wittend/PSWS-FX3-HF103/README.md

# PSWS-FX3-HF103
An SDR radio design  based on Oskar Stella's HF103
