wittend/PSWS-FX3-HF103/Local Resources/LTC2208/LTC2208 Demobpard.png

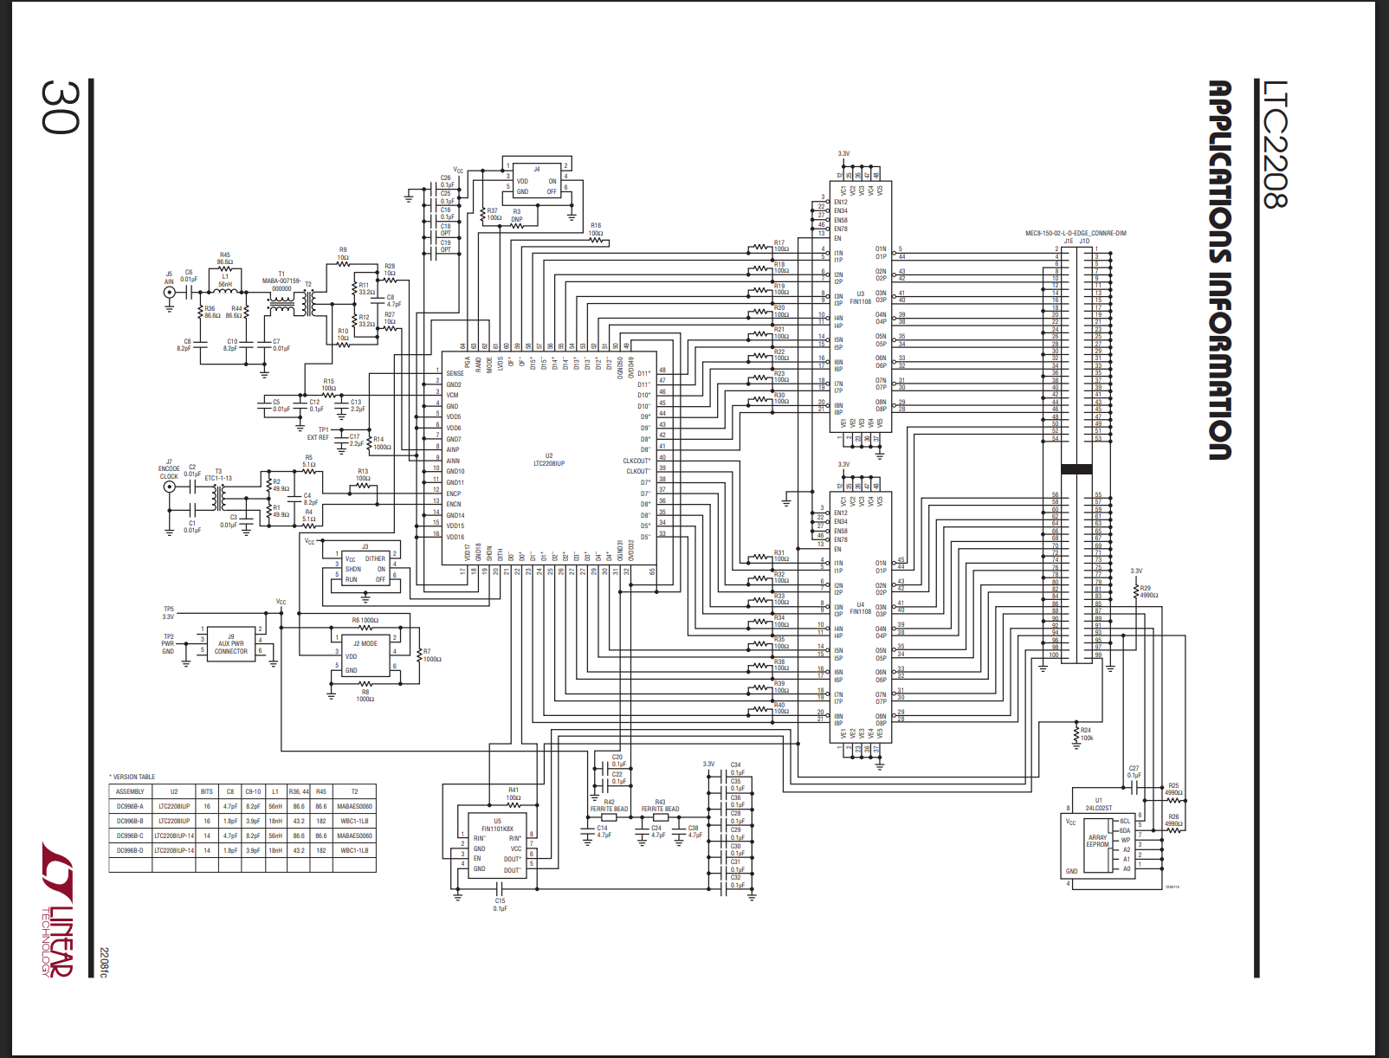
Local Resources/LTC2208/LTC2208 Demobpard.png
