wittend/PSWS-FX3-HF103/Local Resources/CYUSB3014-BZXCT/CYUSB3014-BZXCT.step

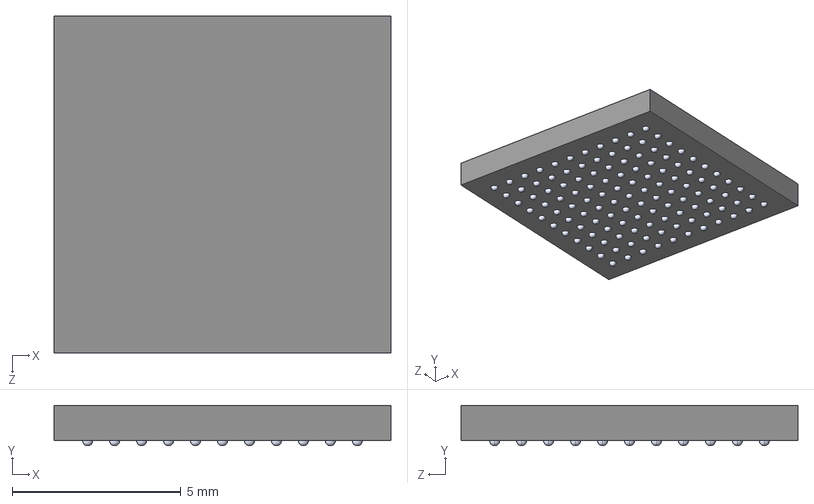
[picture p2: CAD file, 2025-09-26]
Local Resources/CYUSB3014-BZXCT/CYUSB3014-BZXCT.step
10.0 x 1.20 x 10.0 mm
