wittend/PSWS-FX3-HF103/Local Resources/ETC1-1T-2TR/3D/ETC1-1T-2TR.stp

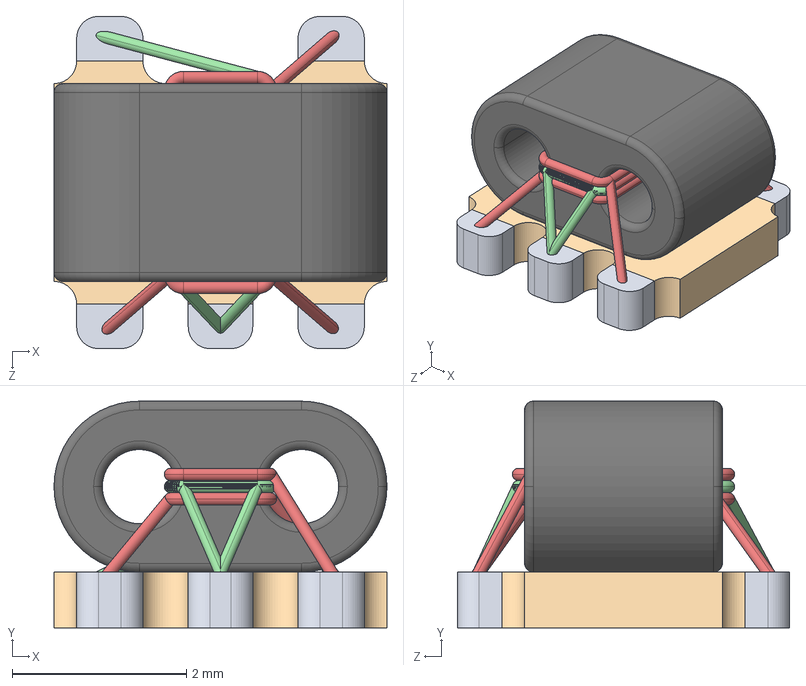
[picture p3: CAD file, 2025-09-26]
Local Resources/ETC1-1T-2TR/3D/ETC1-1T-2TR.stp
3.82 x 2.60 x 3.81 mm
