wittend/PSWS-FX3-HF103/Local Resources/LTC2208/LTC2208CUP_PBF.step

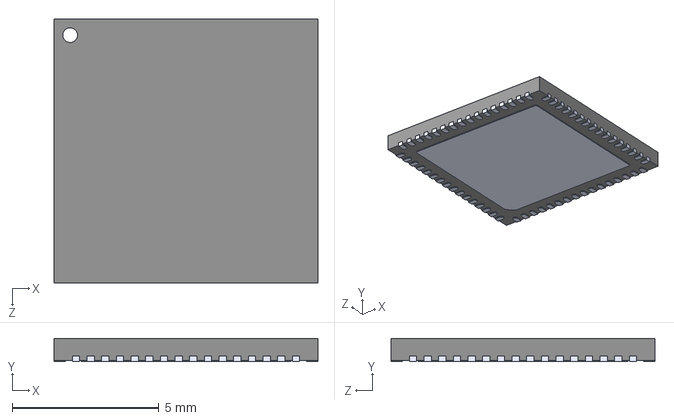
[picture p4: CAD file, 2025-09-26]
Local Resources/LTC2208/LTC2208CUP_PBF.step
9.00 x 0.8 x 9.00 mm
