wittend/PSWS-FX3-HF103/Local Resources/Si5351/SI5351A-B-GT.step

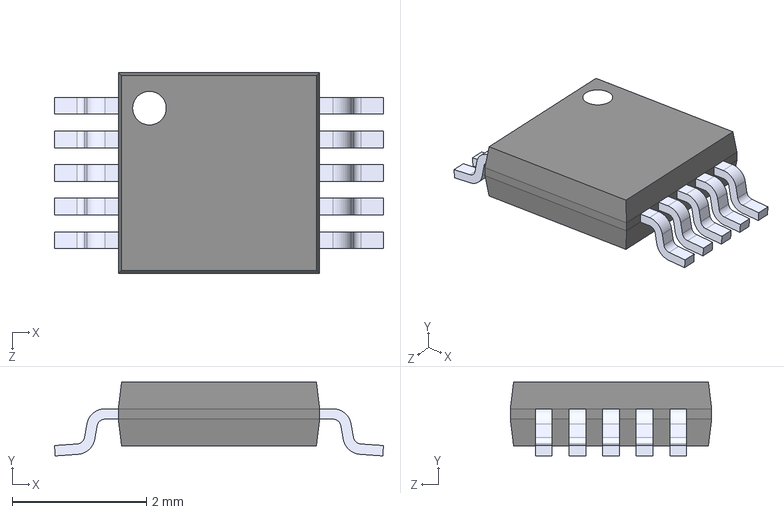
[picture p5: CAD file, 2025-09-26]
Local Resources/Si5351/SI5351A-B-GT.step
4.90 x 1.10 x 3.00 mm
