wittend/PSWS-FX3-HF103/(list of files, cad)

Other CAD files:
Local Resources/ETC1-1T-2TR/Allegro/e_series_1.psm
Local Resources/ETC1-1T-2TR/DEHDL/etc1_1t_2tr/chips/chips.prt
