wittend/PSWS-FX3-HF103/Local Resources/Schematic_as_PDF-2025-06-27.pdf

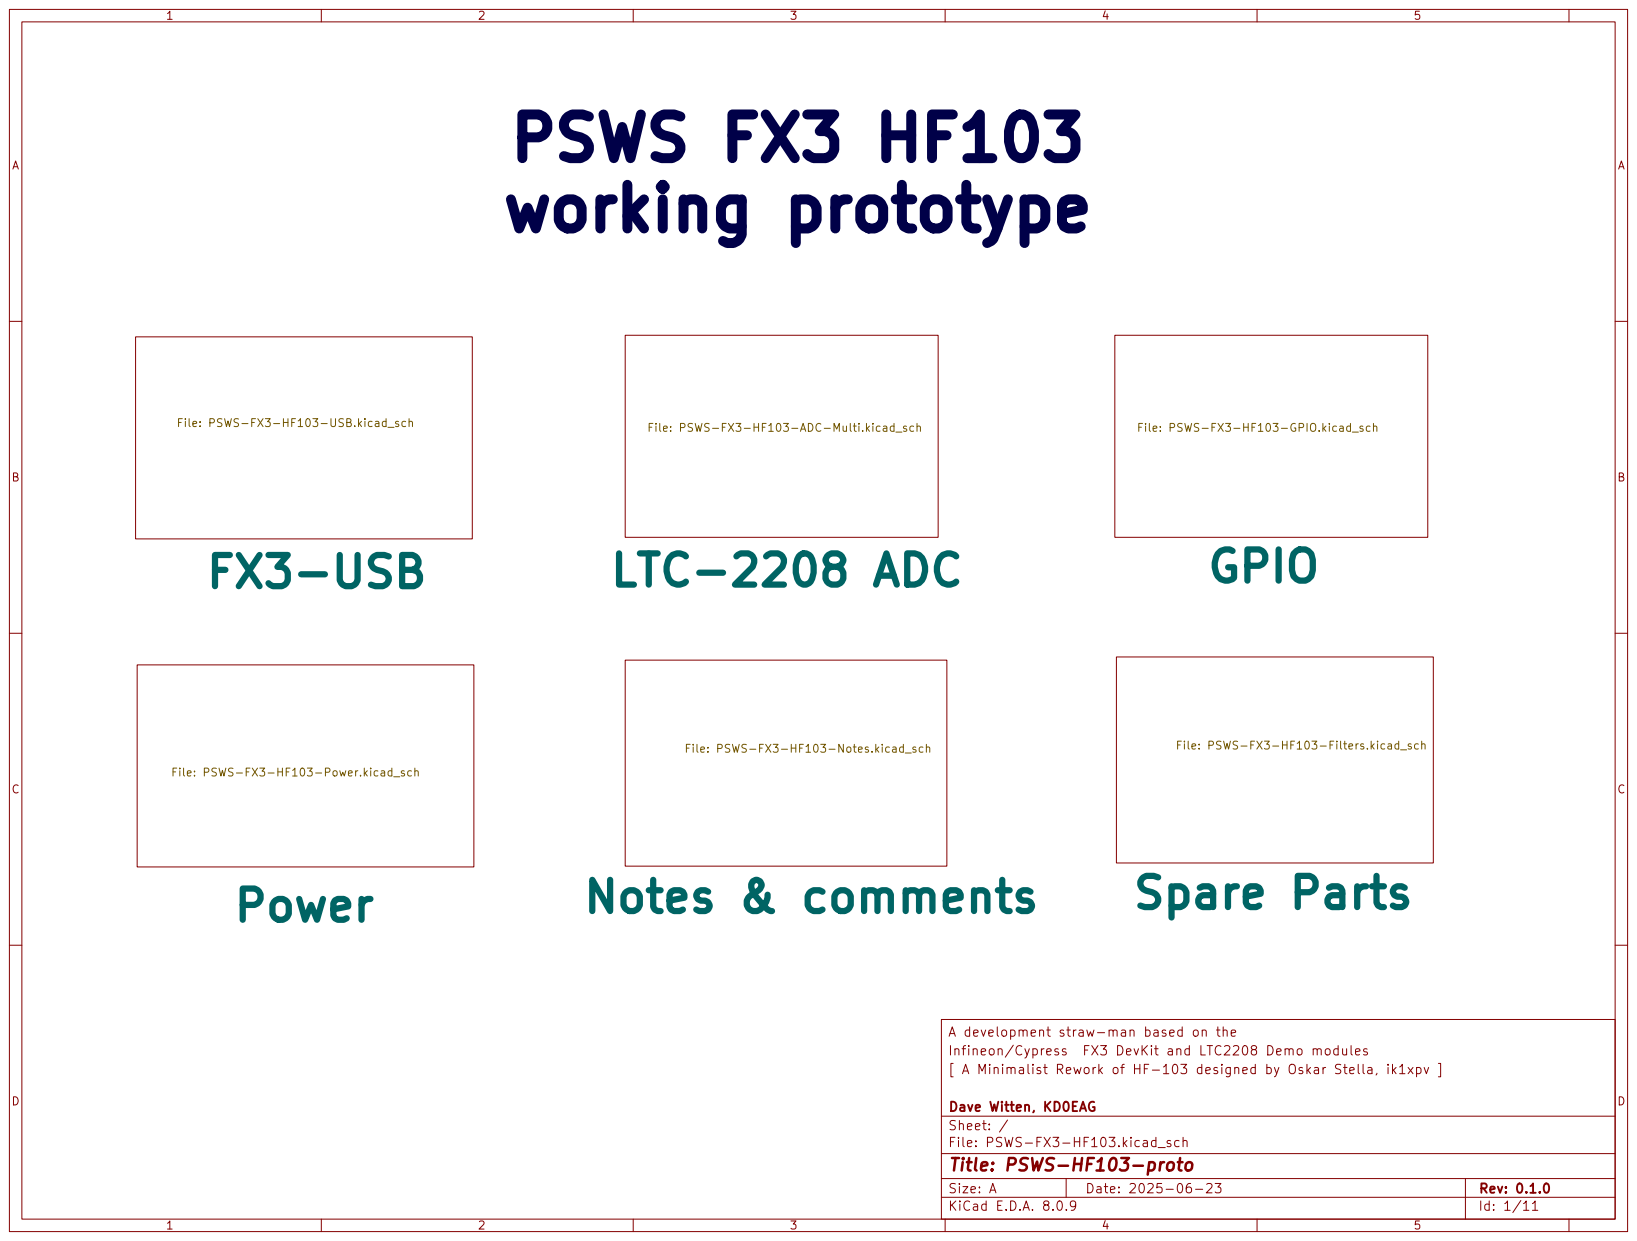
[picture p6: page 1]

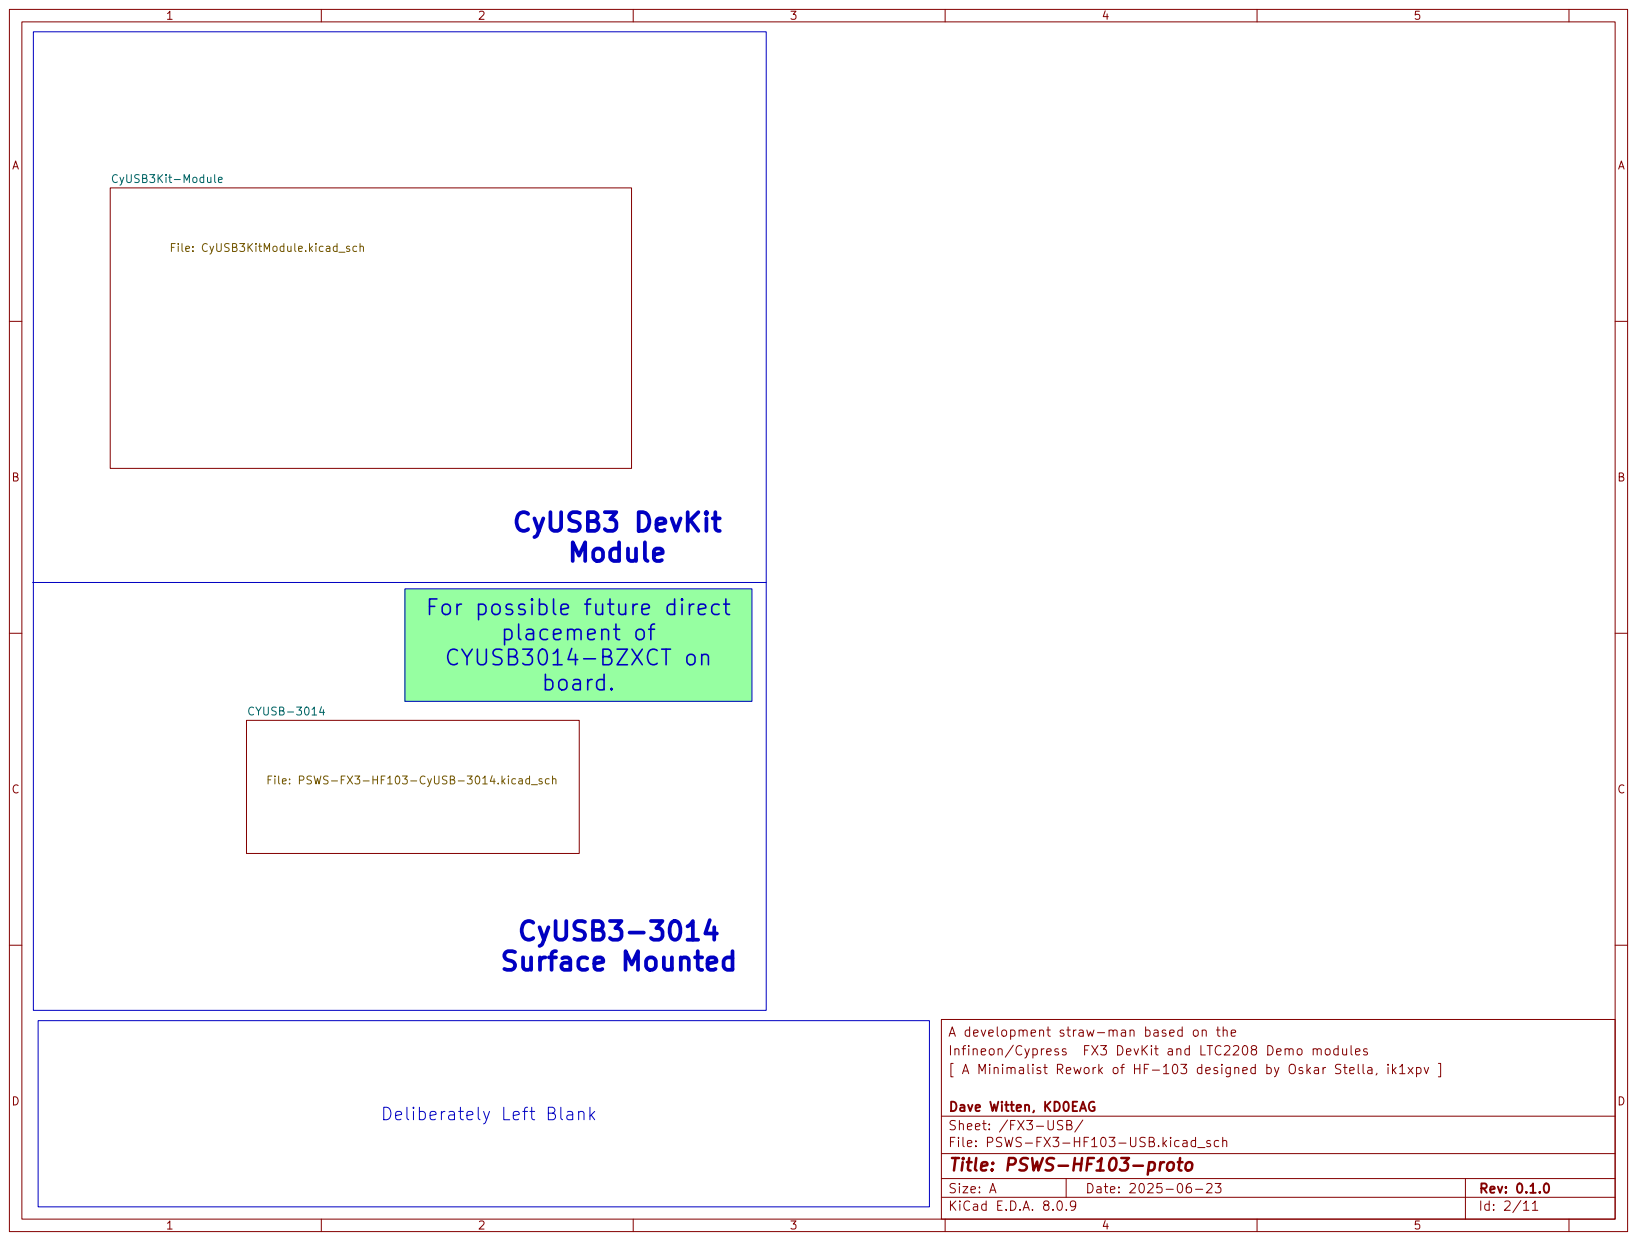
[picture p7: page 2]

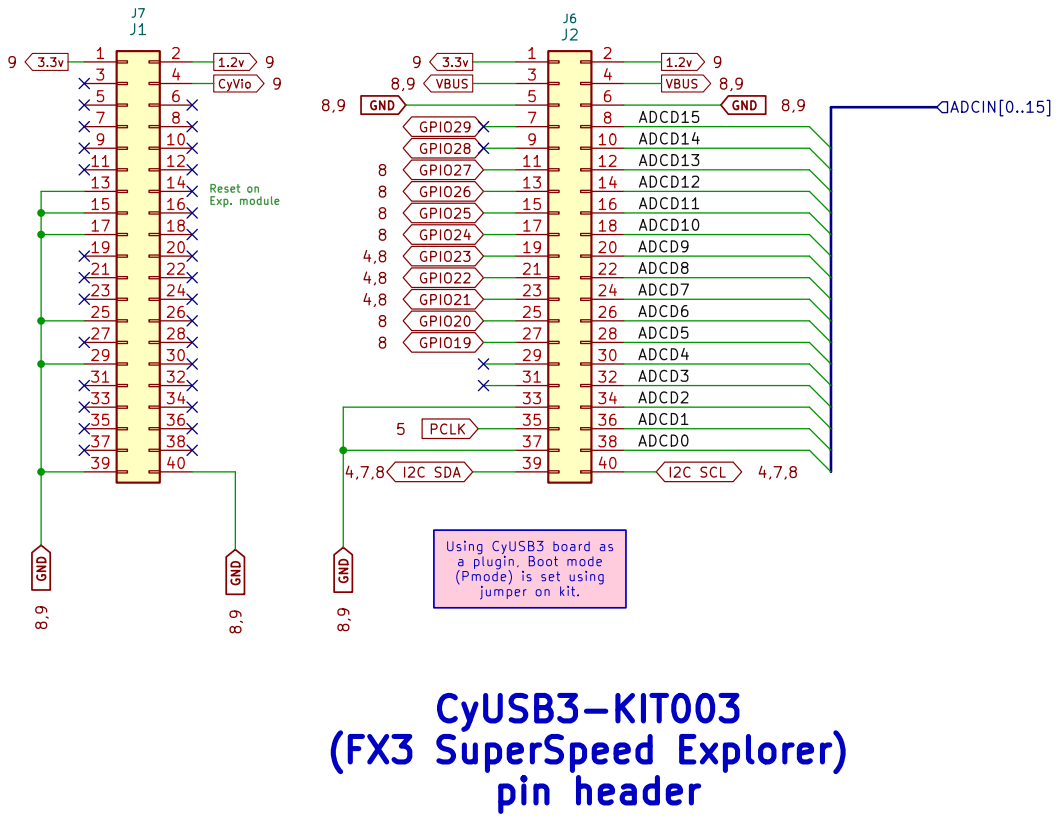
[picture p8: page 3]

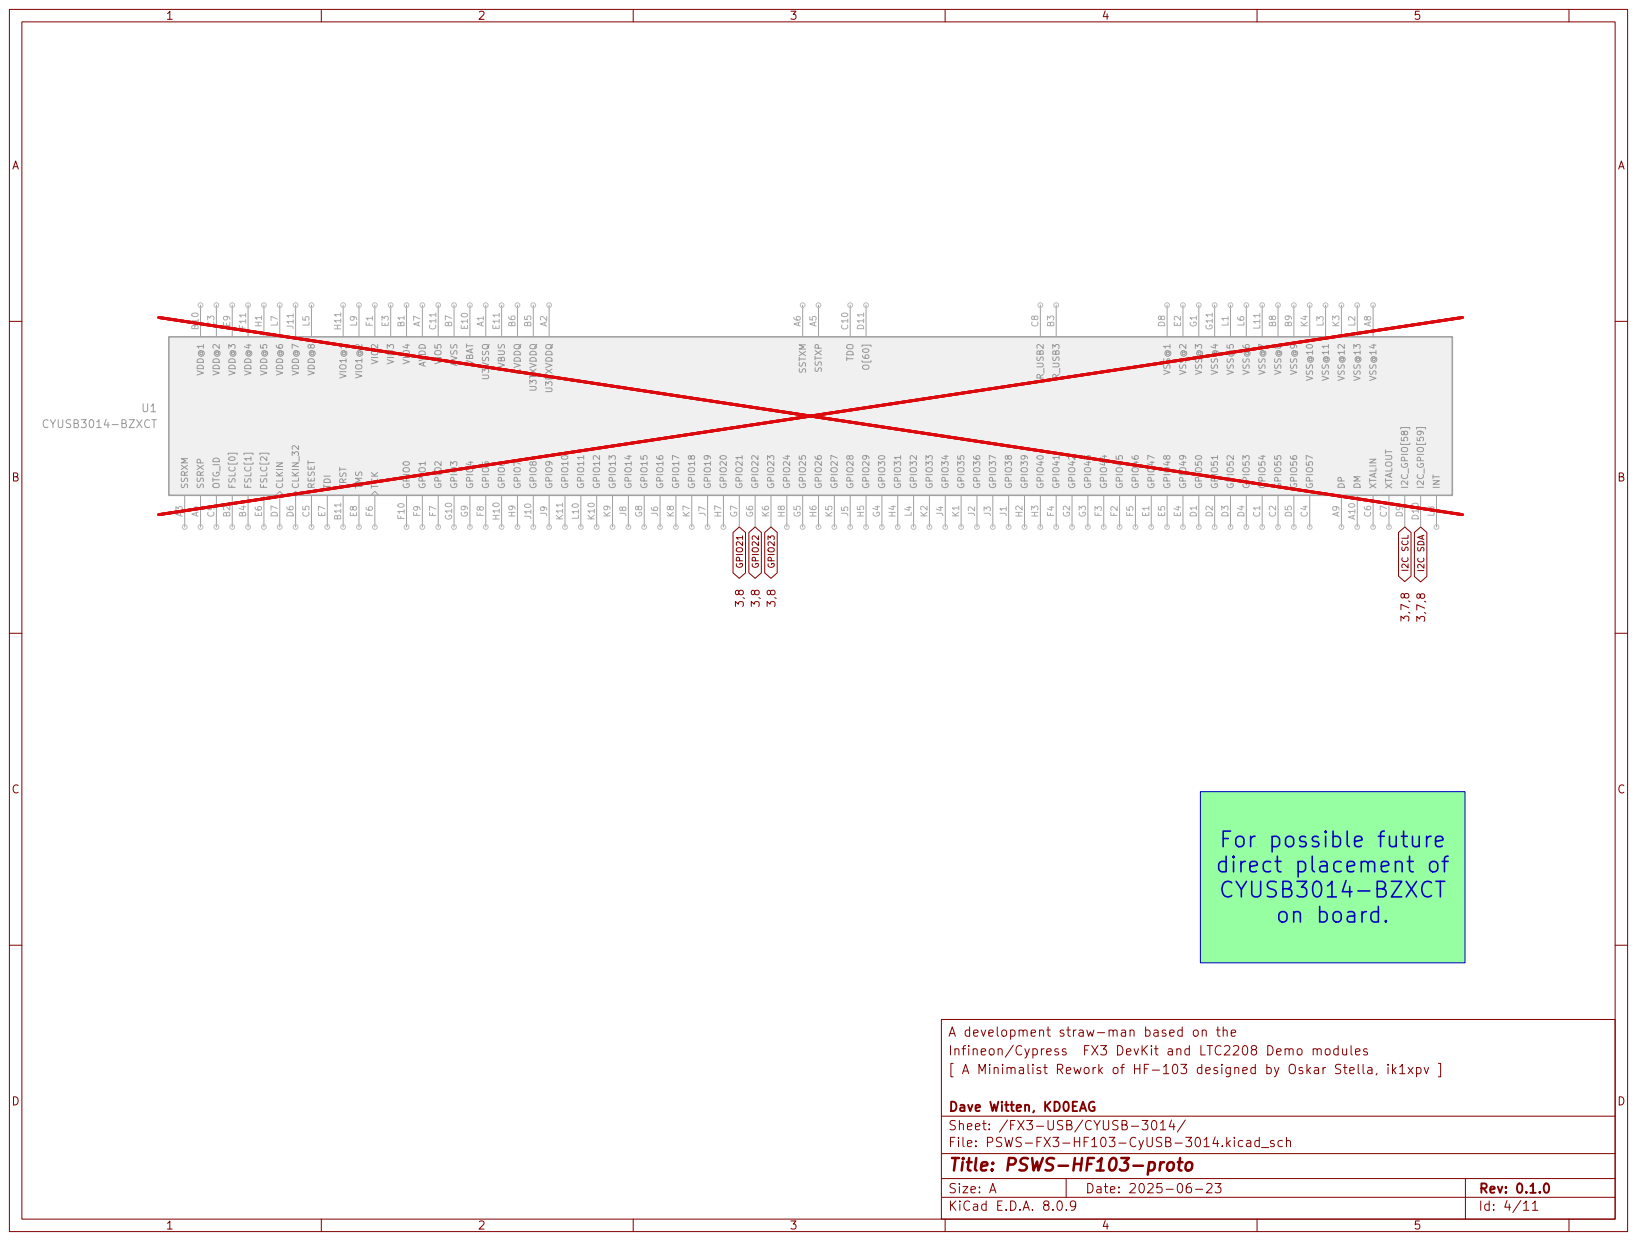
[picture p9: page 4]

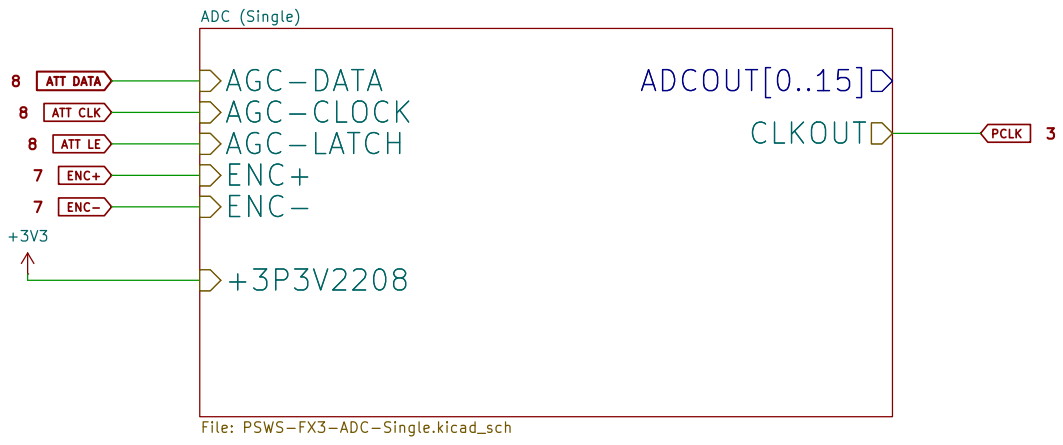
[picture p10: page 5]

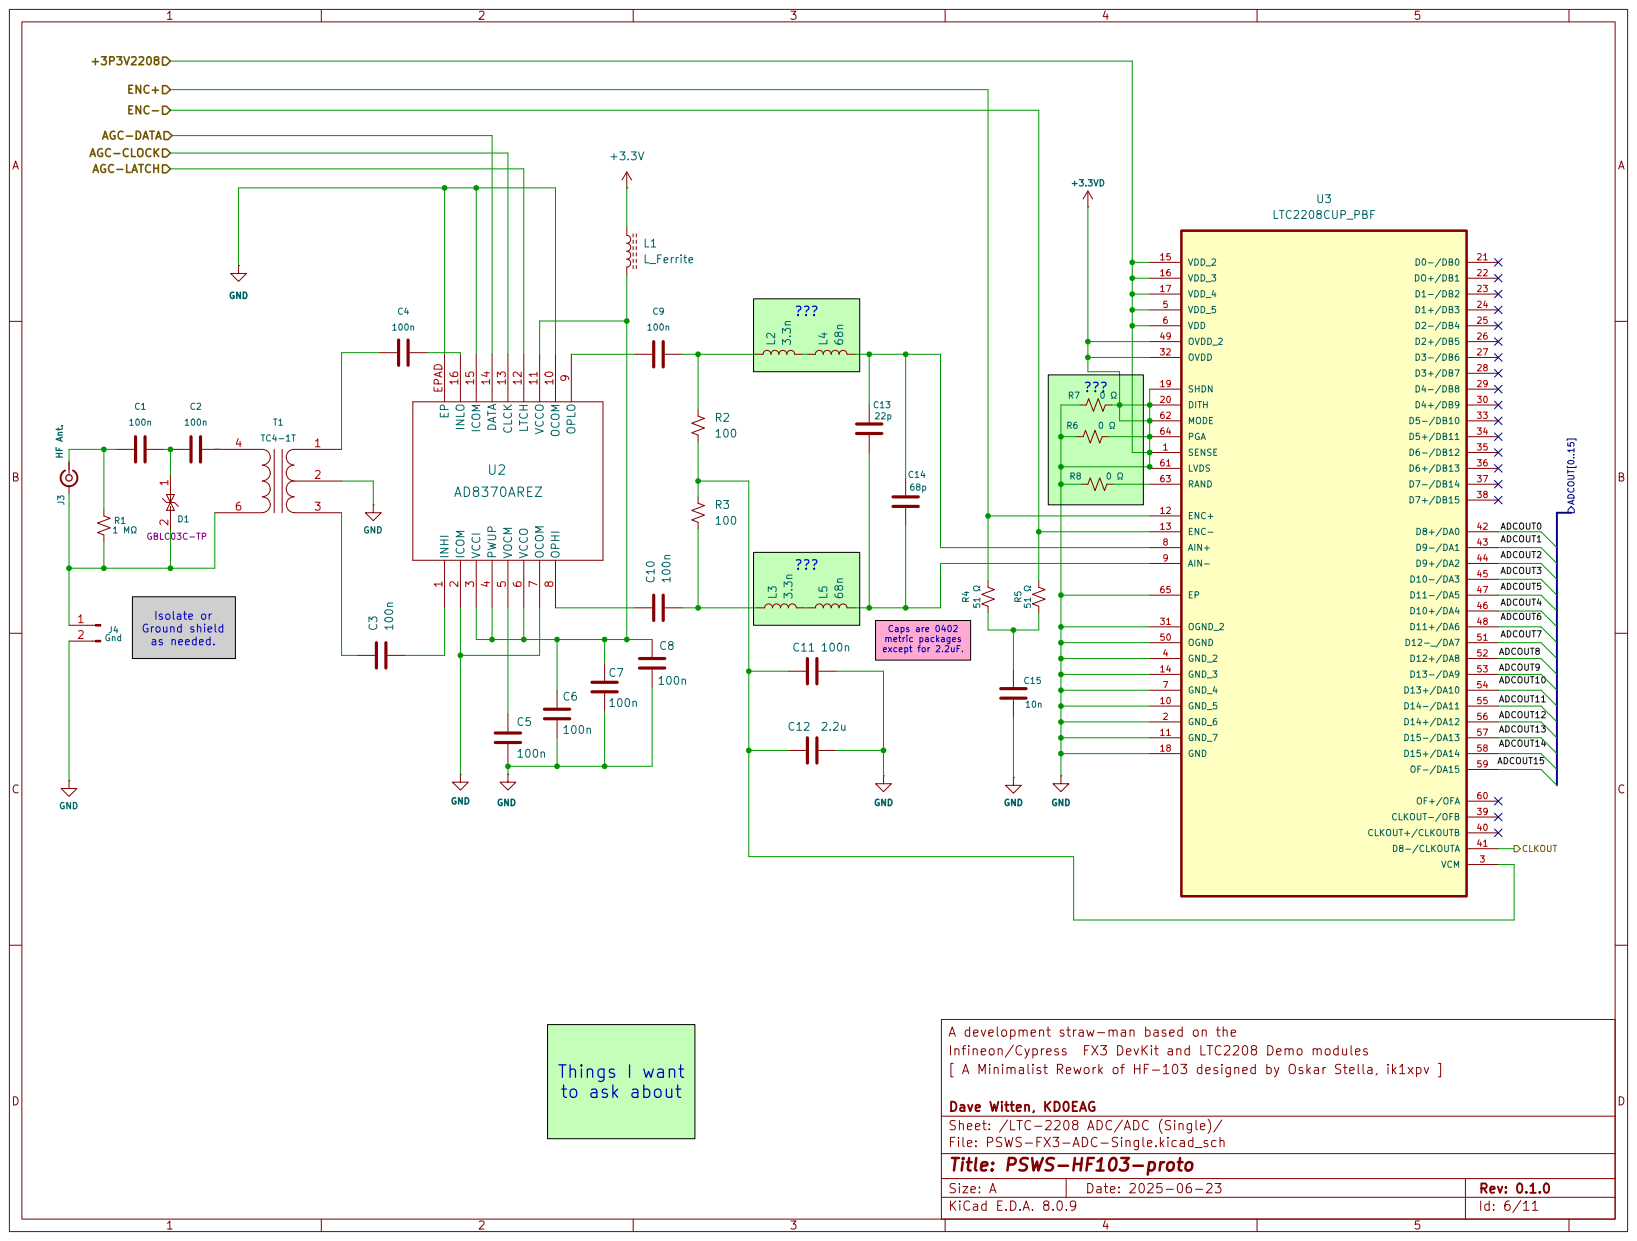
[picture p11: page 6]

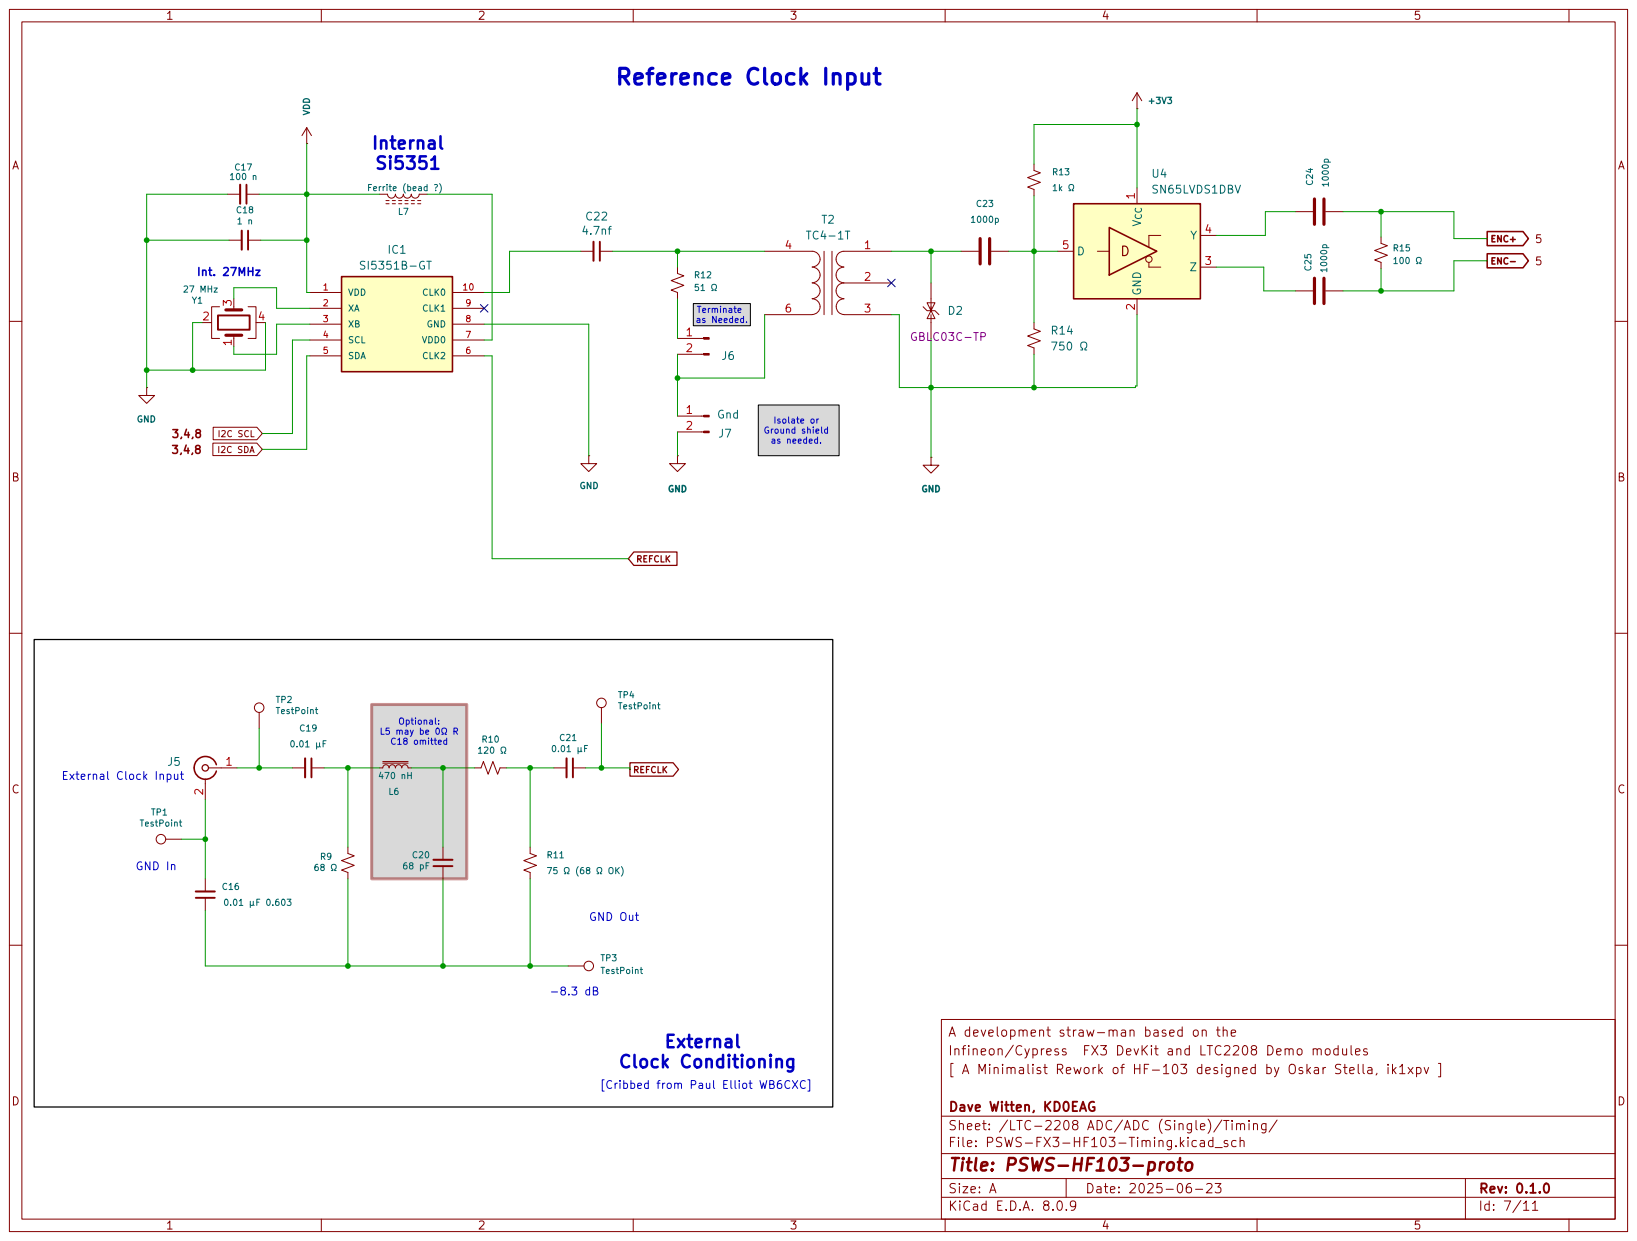
[picture p12: page 7]

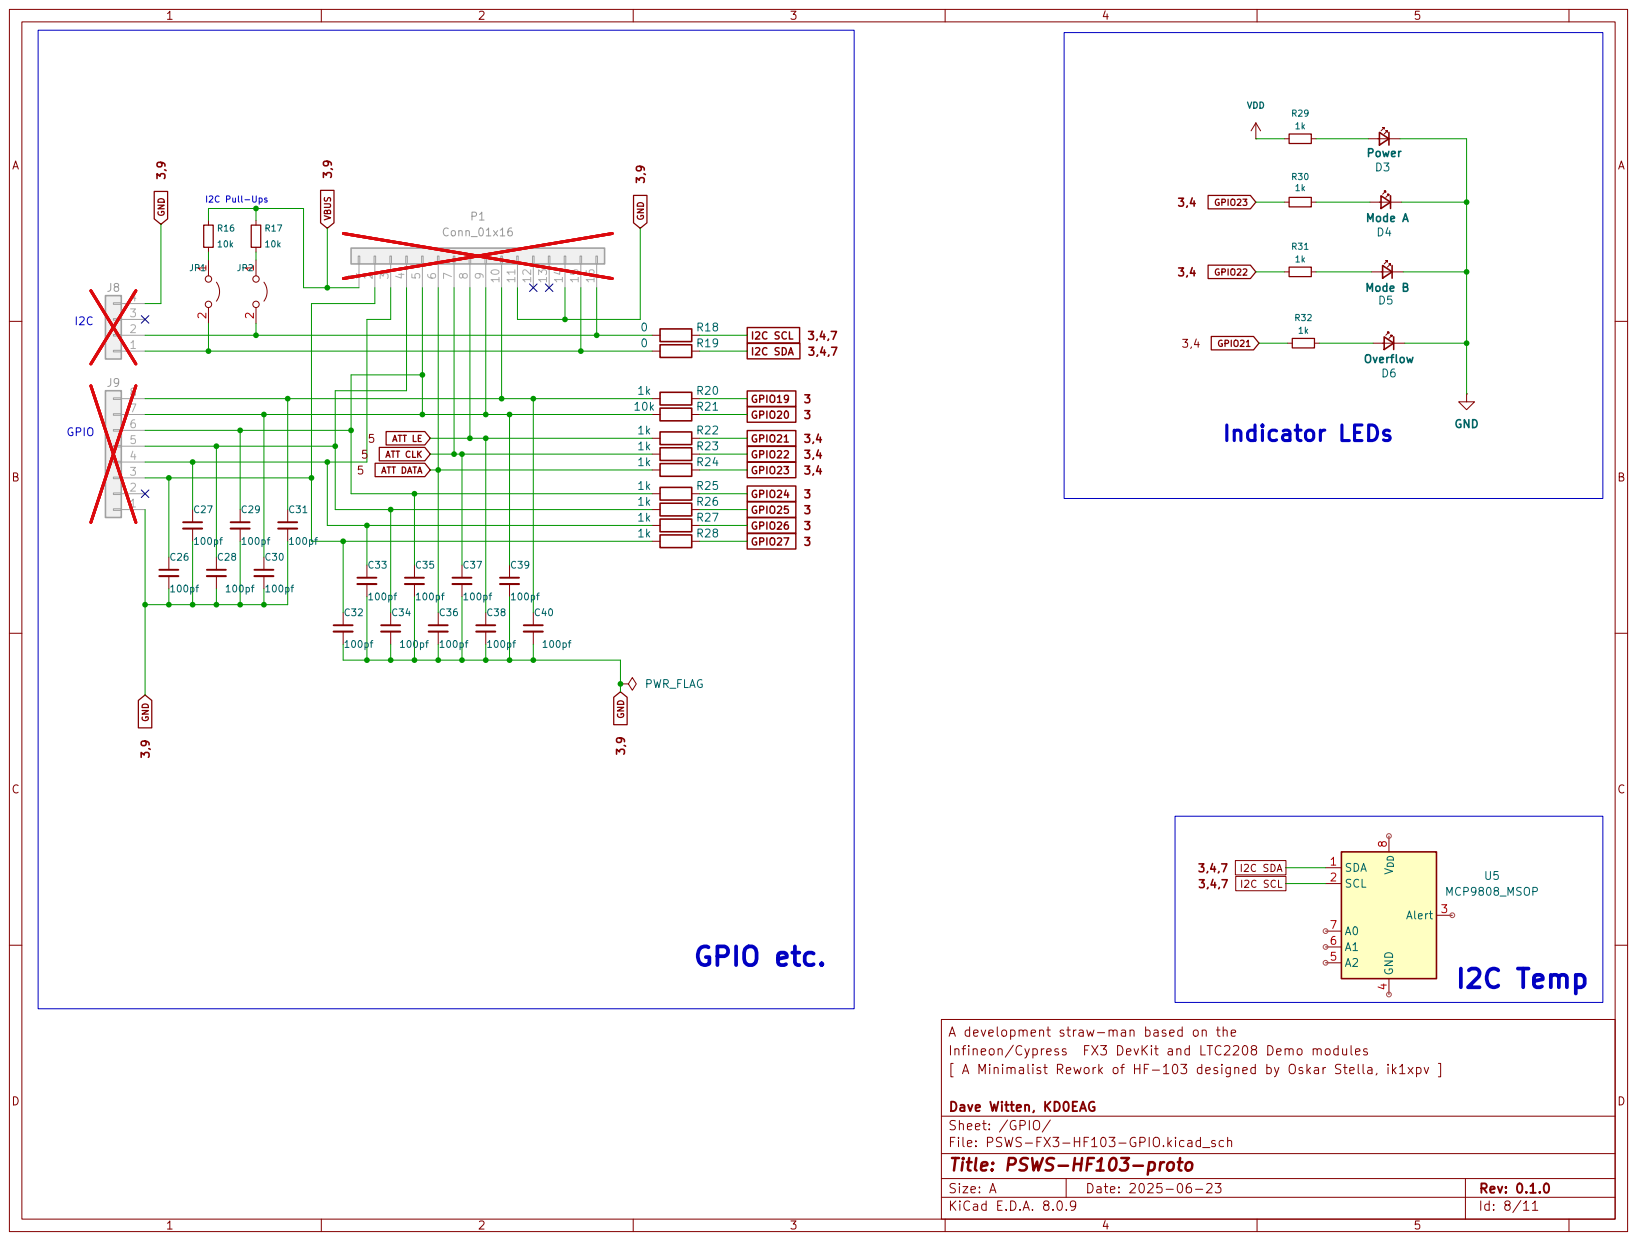
[picture p13: page 8]

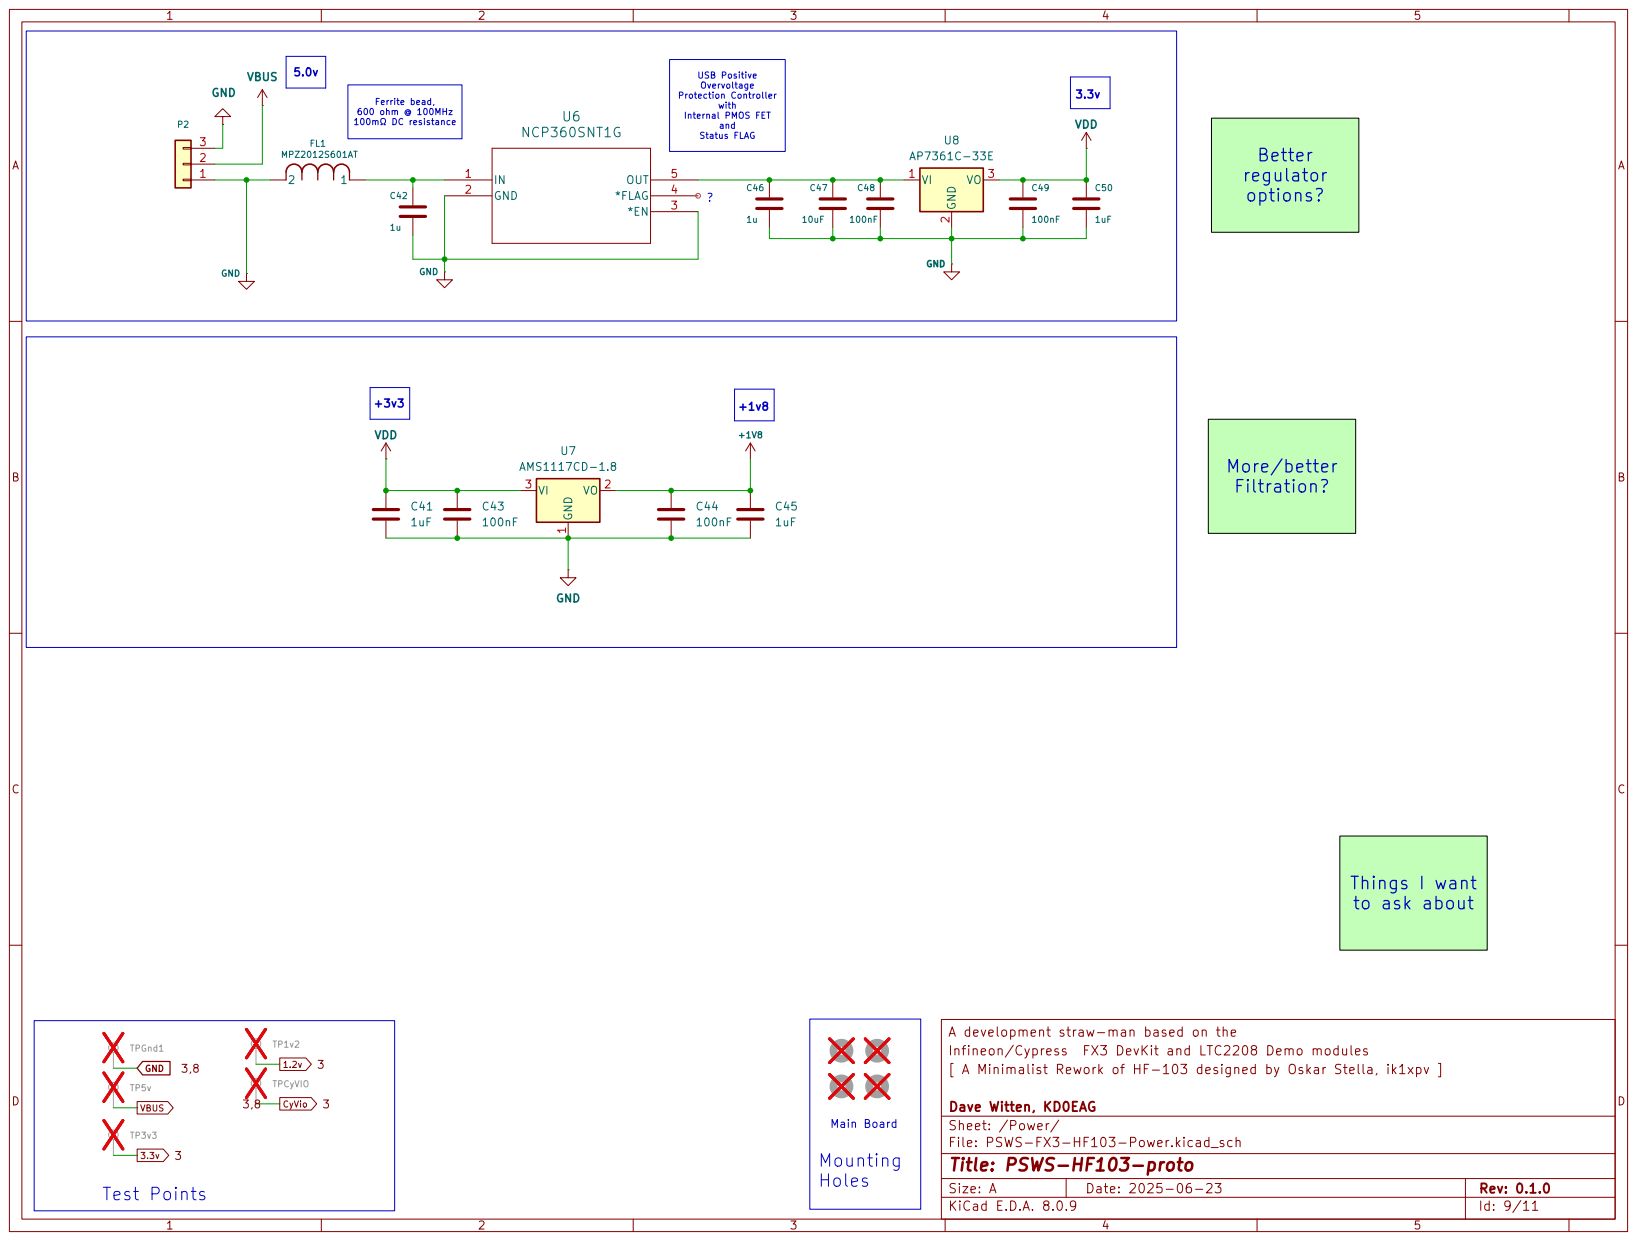
[picture p14: page 9]

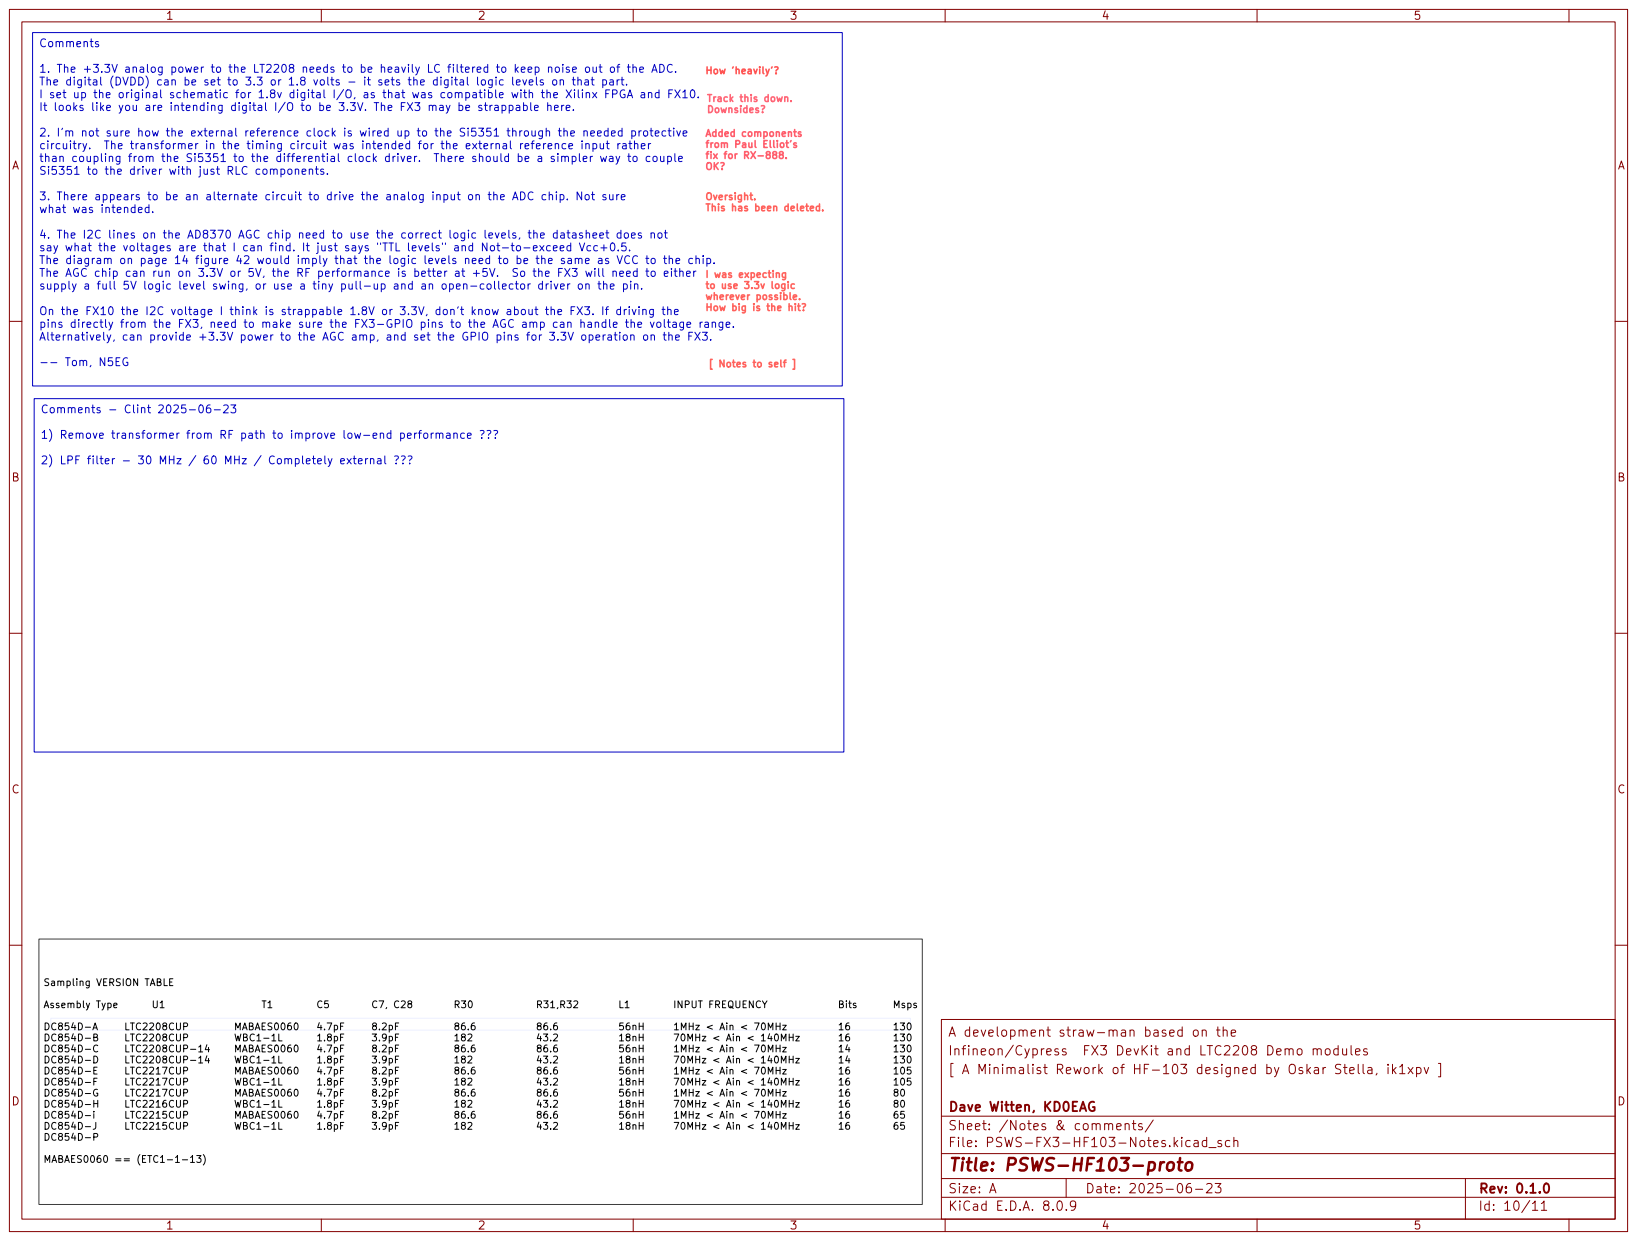
[picture p15: page 10]

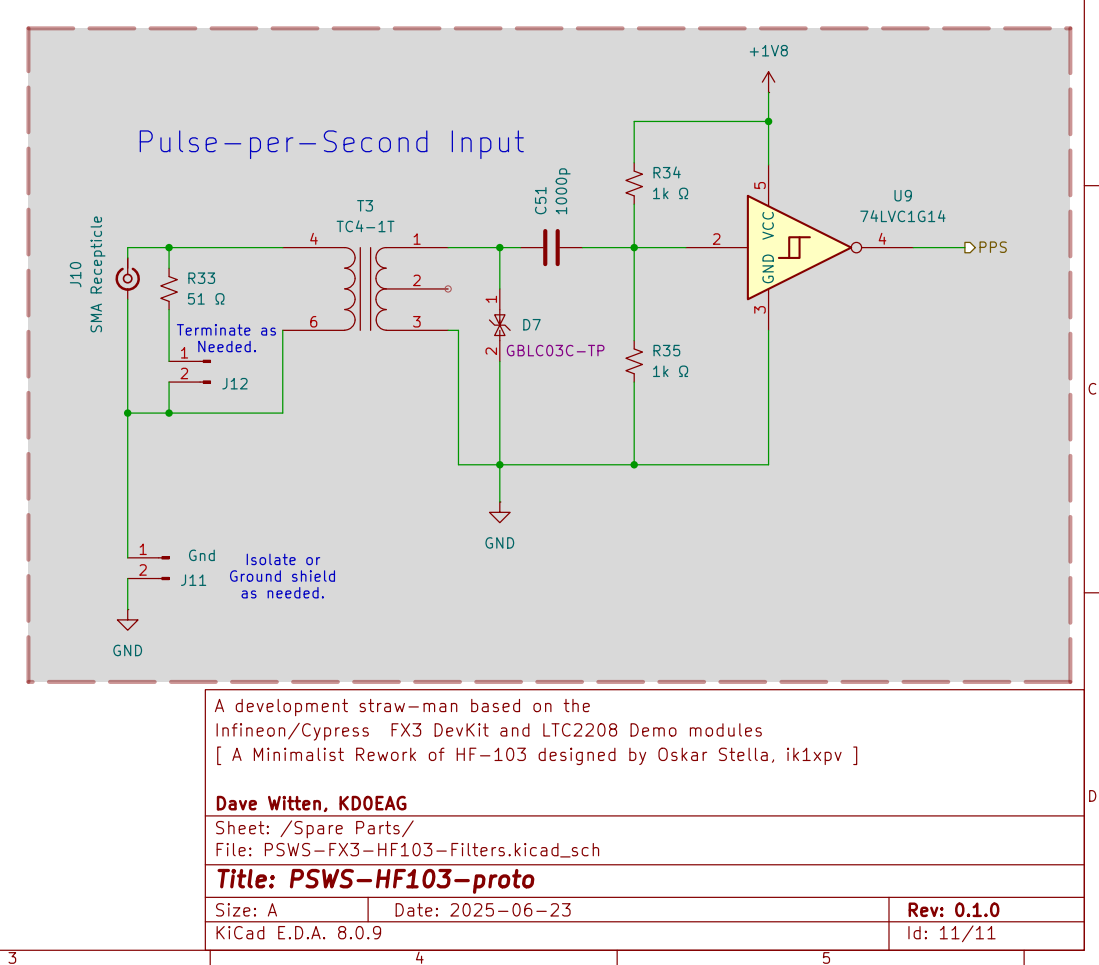
[picture p16: page 11]
