wittend/PSWS-FX3-HF103/CyUSB3KitModule.kicad_sch

## KiCad design CyUSB3KitModule.kicad_sch (2025-09-26)

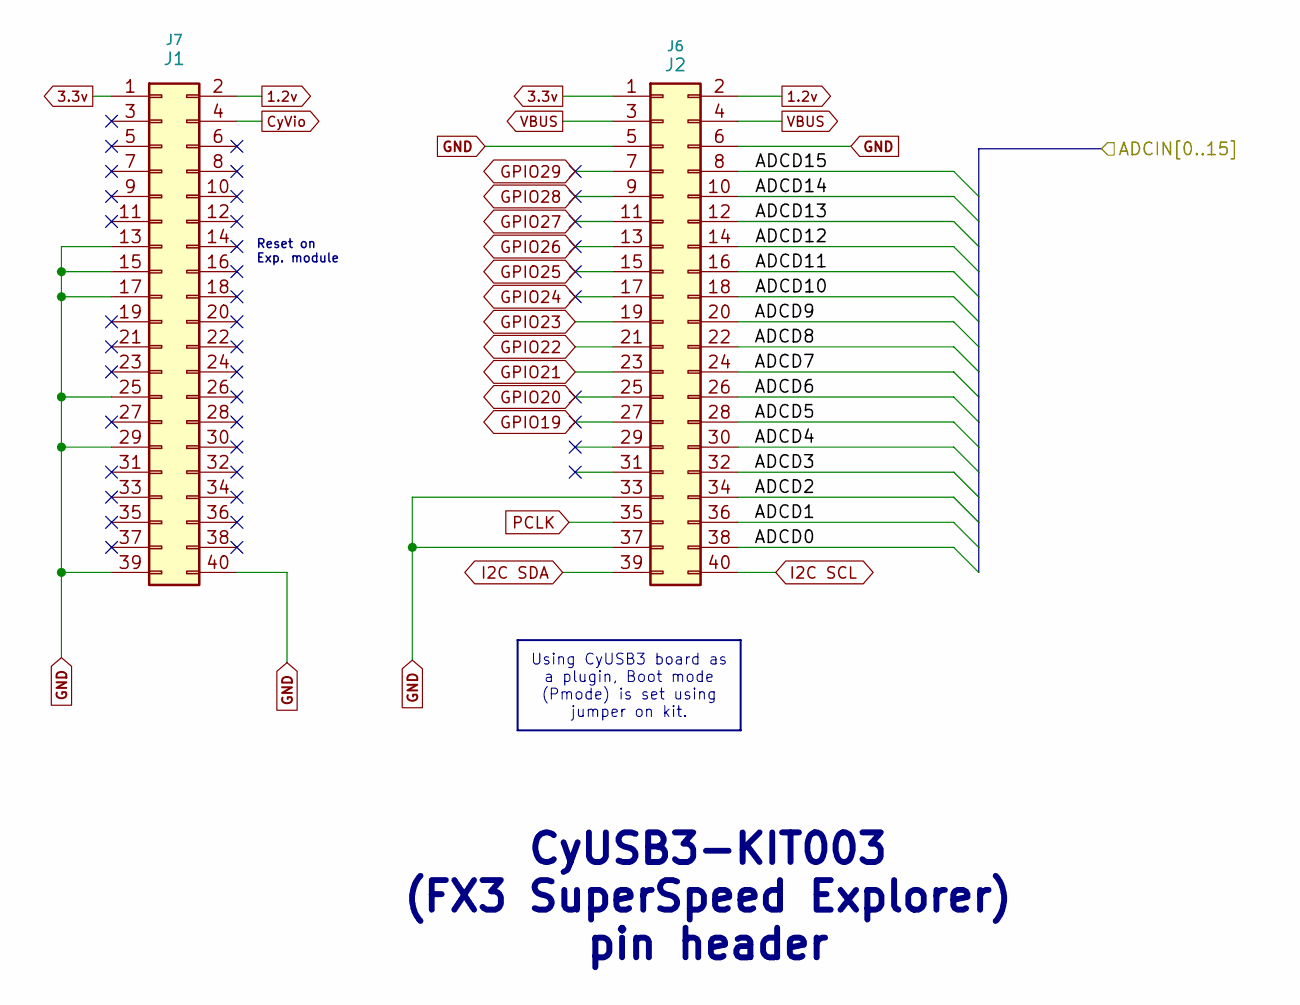
[picture p17: schematic CyUSB3KitModule.kicad_sch]

Parts:
J1: J7; PinSocket_2x20_P2.54mm_Vertical
J2: J6; PinSocket_2x20_P2.54mm_Vertical

Connections:
1.2v: J1.2, J2.2
3.3v: J1.1, J2.1
ADCD0: J2.38
ADCD1: J2.36
ADCD2: J2.34
ADCD3: J2.32
ADCD4: J2.30
ADCD5: J2.28
ADCD6: J2.26
ADCD7: J2.24
ADCD8: J2.22
ADCD9: J2.20
ADCD10: J2.18
ADCD11: J2.16
ADCD12: J2.14
ADCD13: J2.12
ADCD14: J2.10
ADCD15: J2.8
CyVio: J1.4
GND: J1.13, J1.15, J1.17, J1.25, J1.29, J1.39, J1.40, J2.5, J2.6, J2.33, J2.37
GPIO19: J2.27
GPIO20: J2.25
GPIO21: J2.23
GPIO22: J2.21
GPIO23: J2.19
GPIO24: J2.17
GPIO25: J2.15
GPIO26: J2.13
GPIO27: J2.11
GPIO28: J2.9
GPIO29: J2.7
I2C SCL: J2.40
I2C SDA: J2.39
PCLK: J2.35
VBUS: J2.3, J2.4

Notes on the sheet:
Using CyUSB3 board as a plugin, Boot mode (Pmode) is set using jumper on kit.
Reset on Exp. module
CyUSB3-KIT003 (FX3 SuperSpeed Explorer) pin header
