wittend/PSWS-FX3-HF103/PSWS-FX3-ADC-Single.kicad_sch

## KiCad design PSWS-FX3-ADC-Single.kicad_sch (2025-09-26)

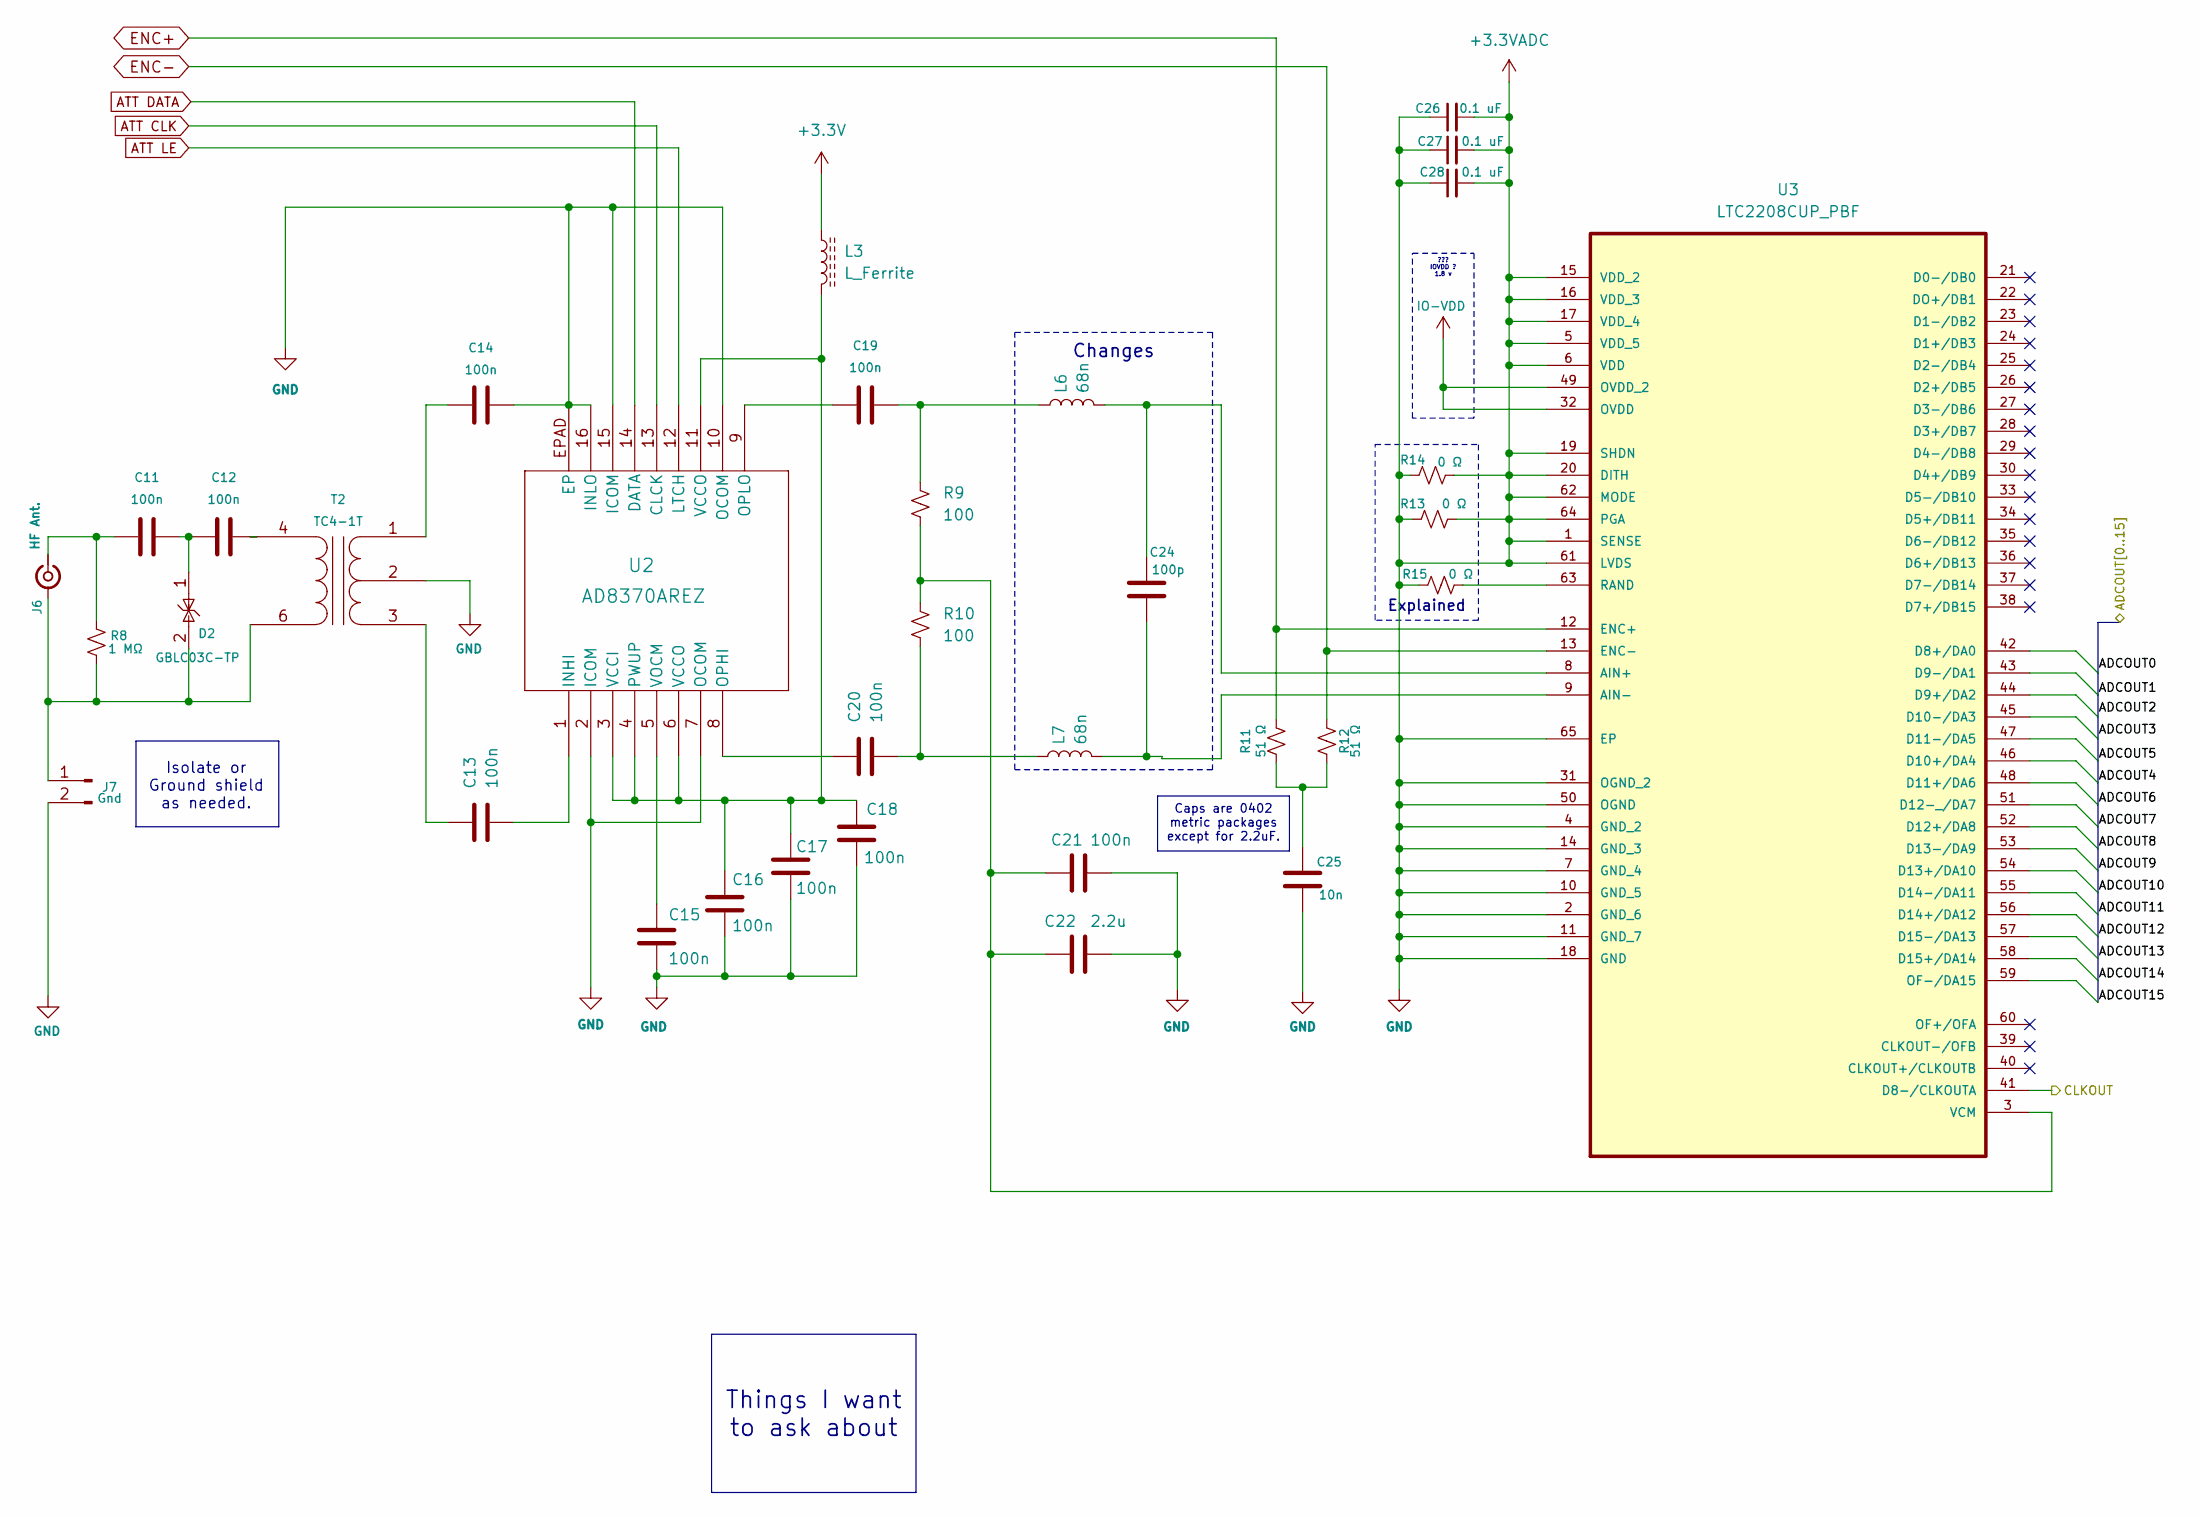
[picture p18: schematic PSWS-FX3-ADC-Single.kicad_sch]

Parts:
C11, C12, C13, C14, C15, C16, C17, C18, C19, C20, C21: 100n; C_0805_2012Metric
C22: 2.2u; C_0805_2012Metric
C24: 100p; C_0805_2012Metric
C25: 10n; C_0805_2012Metric
C26, C27, C28: 0.1 uF
D2: (no value)
J6: HF Ant.
J7: Gnd
L3: L_Ferrite
L6, L7: 68n
R8: 1 MΩ; R_0805_2012Metric
R9, R10: 100; R_0603_1608Metric
R11, R12: 51 Ω; R_0603_1608Metric
R13, R14, R15: 0 Ω; R_0603_1608Metric
T2: TC4-1T
U2: AD8370AREZ; RE_16_2_ADI
U3: LTC2208CUP_PBF; QFN50P900X900X80-65N; MPN LTC2208CUP#PBF#PBF

Connections:
+3.3V: L3.1
+3.3VADC: C14.2, C15.2, C16.2, C17.2, C18.2, C21.2, C22.2, C25.1, C26.1, C26.2, C27.1, C27.2, C28.1, C28.2, J7.2, R13.1, R13.2, R14.1, R14.2, R15.1, T2.2 (SC), U2.2 (ICOM), U2.7 (OCOM), U2.10 (OCOM), U2.15 (ICOM), U2.16 (INLO), U2.EPAD (EP), U3.1 (SENSE), U3.2 (GND_6), U3.4 (GND_2), U3.5 (VDD_5), U3.6 (VDD), U3.7 (GND_4), U3.10 (GND_5), U3.11 (GND_7), U3.14 (GND_3), U3.15 (VDD_2), U3.16 (VDD_3), U3.17 (VDD_4), U3.18 (GND), U3.19 (SHDN), U3.20 (DITH), U3.31 (OGND_2), U3.50 (OGND), U3.61 (LVDS), U3.62 (MODE), U3.64 (PGA), U3.65 (EP)
ATT CLK: U2.13 (CLCK)
ATT DATA: U2.14 (DATA)
ATT LE: U2.12 (LTCH)
CLKOUT: U3.41 (D8-/CLKOUTA)
ENC+: R11.2, U3.12 (ENC+)
ENC-: R12.2, U3.13 (ENC-)
IO-VDD: U3.32 (OVDD), U3.49 (OVDD_2)
unnamed: C11.1, J6.1 (In), R8.1
unnamed: C11.2, C12.1, D2.1 (K)
unnamed: C12.2, T2.4 (AA)
unnamed: C13.1, T2.3 (SA)
unnamed: C13.2, U2.1 (INHI)
unnamed: C14.1, T2.1 (SB)
unnamed: C15.1, U2.5 (VOCM)
unnamed: C16.1, C17.1, C18.1, L3.2, U2.3 (VCCI), U2.4 (PWUP), U2.6 (VCCO), U2.11 (VCCO)
unnamed: C19.1, U2.9 (OPLO)
unnamed: C19.2, L6.1, R9.1
unnamed: C20.1, U2.8 (OPHI)
unnamed: C20.2, L7.1, R10.2
unnamed: C21.1, C22.1, R9.2, R10.1, U3.3 (VCM)
unnamed: C24.1, L6.2, U3.8 (AIN+)
unnamed: C24.2, L7.2, U3.9 (AIN-)
unnamed: C25.2, R11.1, R12.1
unnamed: D2.2 (A), J6.2 (Ext), J7.1, R8.2, T2.6 (AB)
unnamed: R15.2, U3.63 (RAND)

Notes on the sheet:
Things I want to ask about
Changes
Caps are 0402 metric packages except for 2.2uF.
Explained
??? IOVDD ? 1.8 v
Isolate or Ground shield as needed.
