wittend/PSWS-FX3-HF103/PSWS-FX3-HF103-ADC.kicad_sch

## KiCad design PSWS-FX3-HF103-ADC.kicad_sch (2025-09-26)

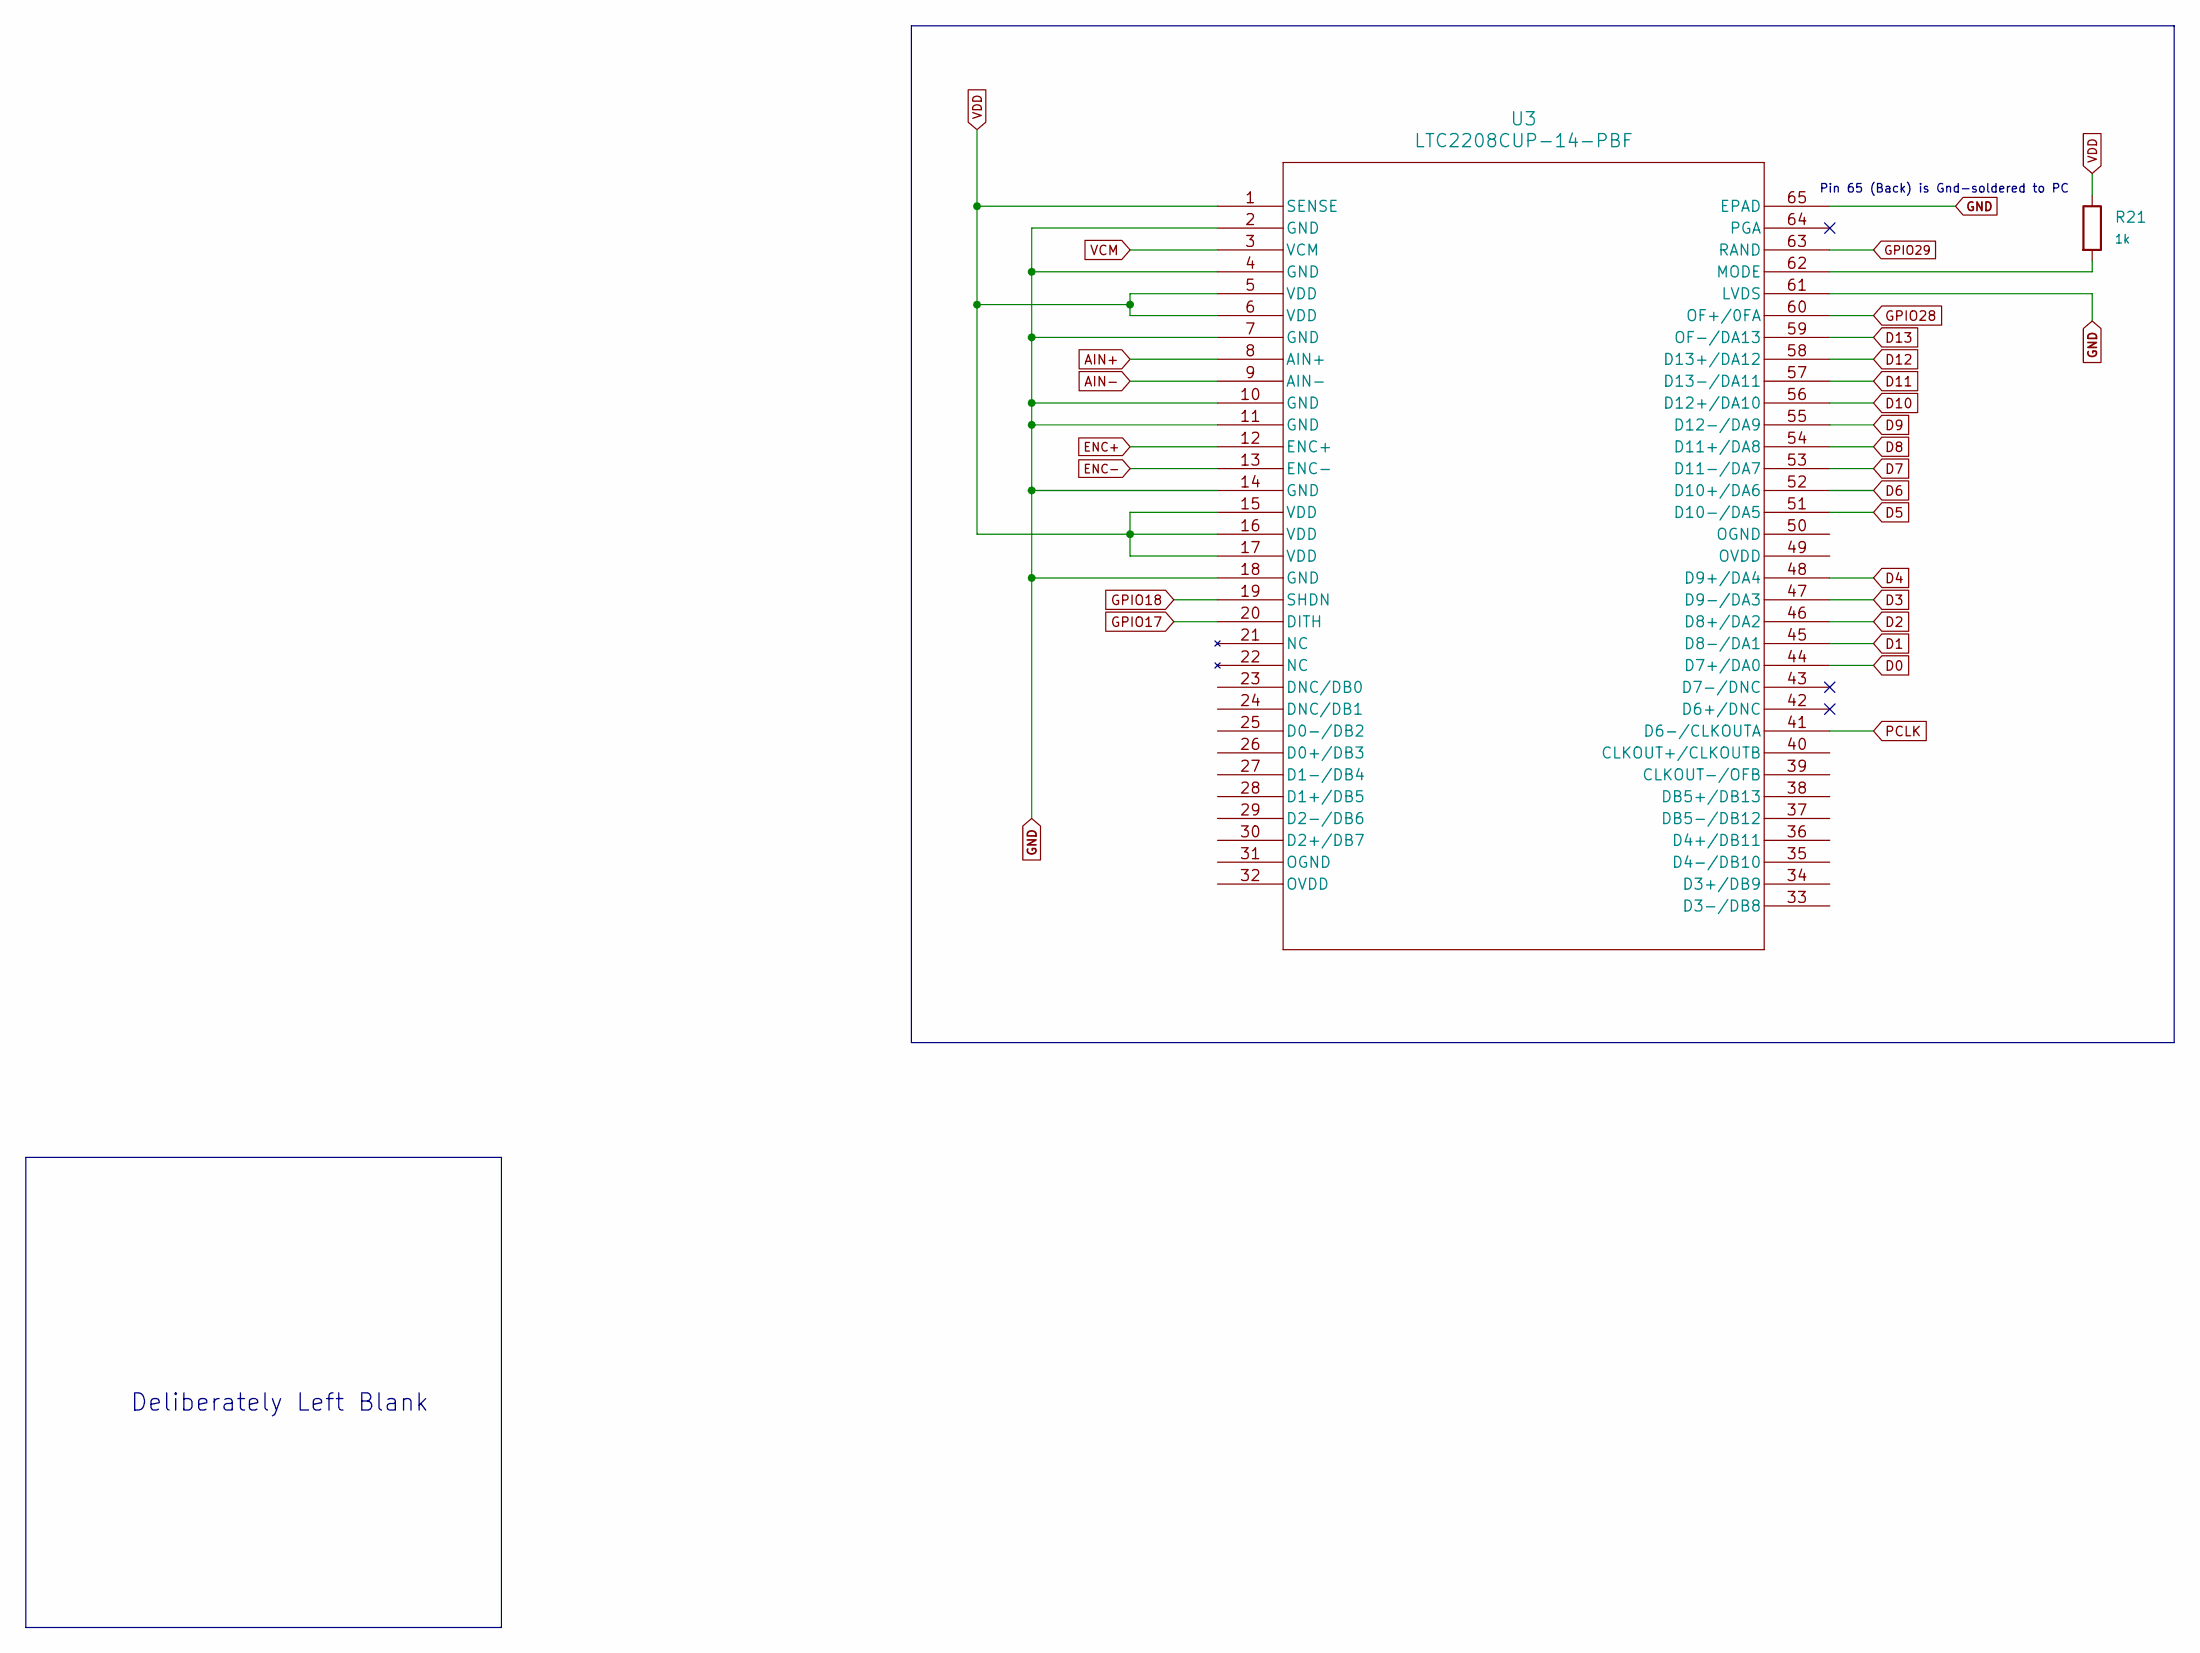
[picture p19: schematic PSWS-FX3-HF103-ADC.kicad_sch]

Parts:
R21: 1k; R_0603_1608Metric
U3: LTC2208CUP-14-PBF; QFN-64-1EP_9x9mm_P0.5mm_EP4.35x4.35mm_ThermalVias

Connections:
AIN+: U3.8 (AIN+)
AIN-: U3.9 (AIN-)
D0: U3.44 (D7+/DA0)
D1: U3.45 (D8-/DA1)
D2: U3.46 (D8+/DA2)
D3: U3.47 (D9-/DA3)
D4: U3.48 (D9+/DA4)
D5: U3.51 (D10-/DA5)
D6: U3.52 (D10+/DA6)
D7: U3.53 (D11-/DA7)
D8: U3.54 (D11+/DA8)
D9: U3.55 (D12-/DA9)
D10: U3.56 (D12+/DA10)
D11: U3.57 (D13-/DA11)
D12: U3.58 (D13+/DA12)
D13: U3.59 (OF-/DA13)
ENC+: U3.12 (ENC+)
ENC-: U3.13 (ENC-)
GND: U3.2 (GND), U3.4 (GND), U3.7 (GND), U3.10 (GND), U3.11 (GND), U3.14 (GND), U3.18 (GND), U3.61 (LVDS), U3.65 (EPAD)
GPIO17: U3.20 (DITH)
GPIO18: U3.19 (SHDN)
GPIO28: U3.60 (OF+/0FA)
GPIO29: U3.63 (RAND)
unnamed: R21.2, U3.62 (MODE)
PCLK: U3.41 (D6-/CLKOUTA)
VCM: U3.3 (VCM)
VDD: R21.1, U3.1 (SENSE), U3.5 (VDD), U3.6 (VDD), U3.15 (VDD), U3.16 (VDD), U3.17 (VDD)

Notes on the sheet:
Pin 65 (Back) is Gnd-soldered to PC
Deliberately Left Blank
