wittend/PSWS-FX3-HF103/PSWS-FX3-HF103-GPIO.kicad_sch

## KiCad design PSWS-FX3-HF103-GPIO.kicad_sch (2025-09-26)

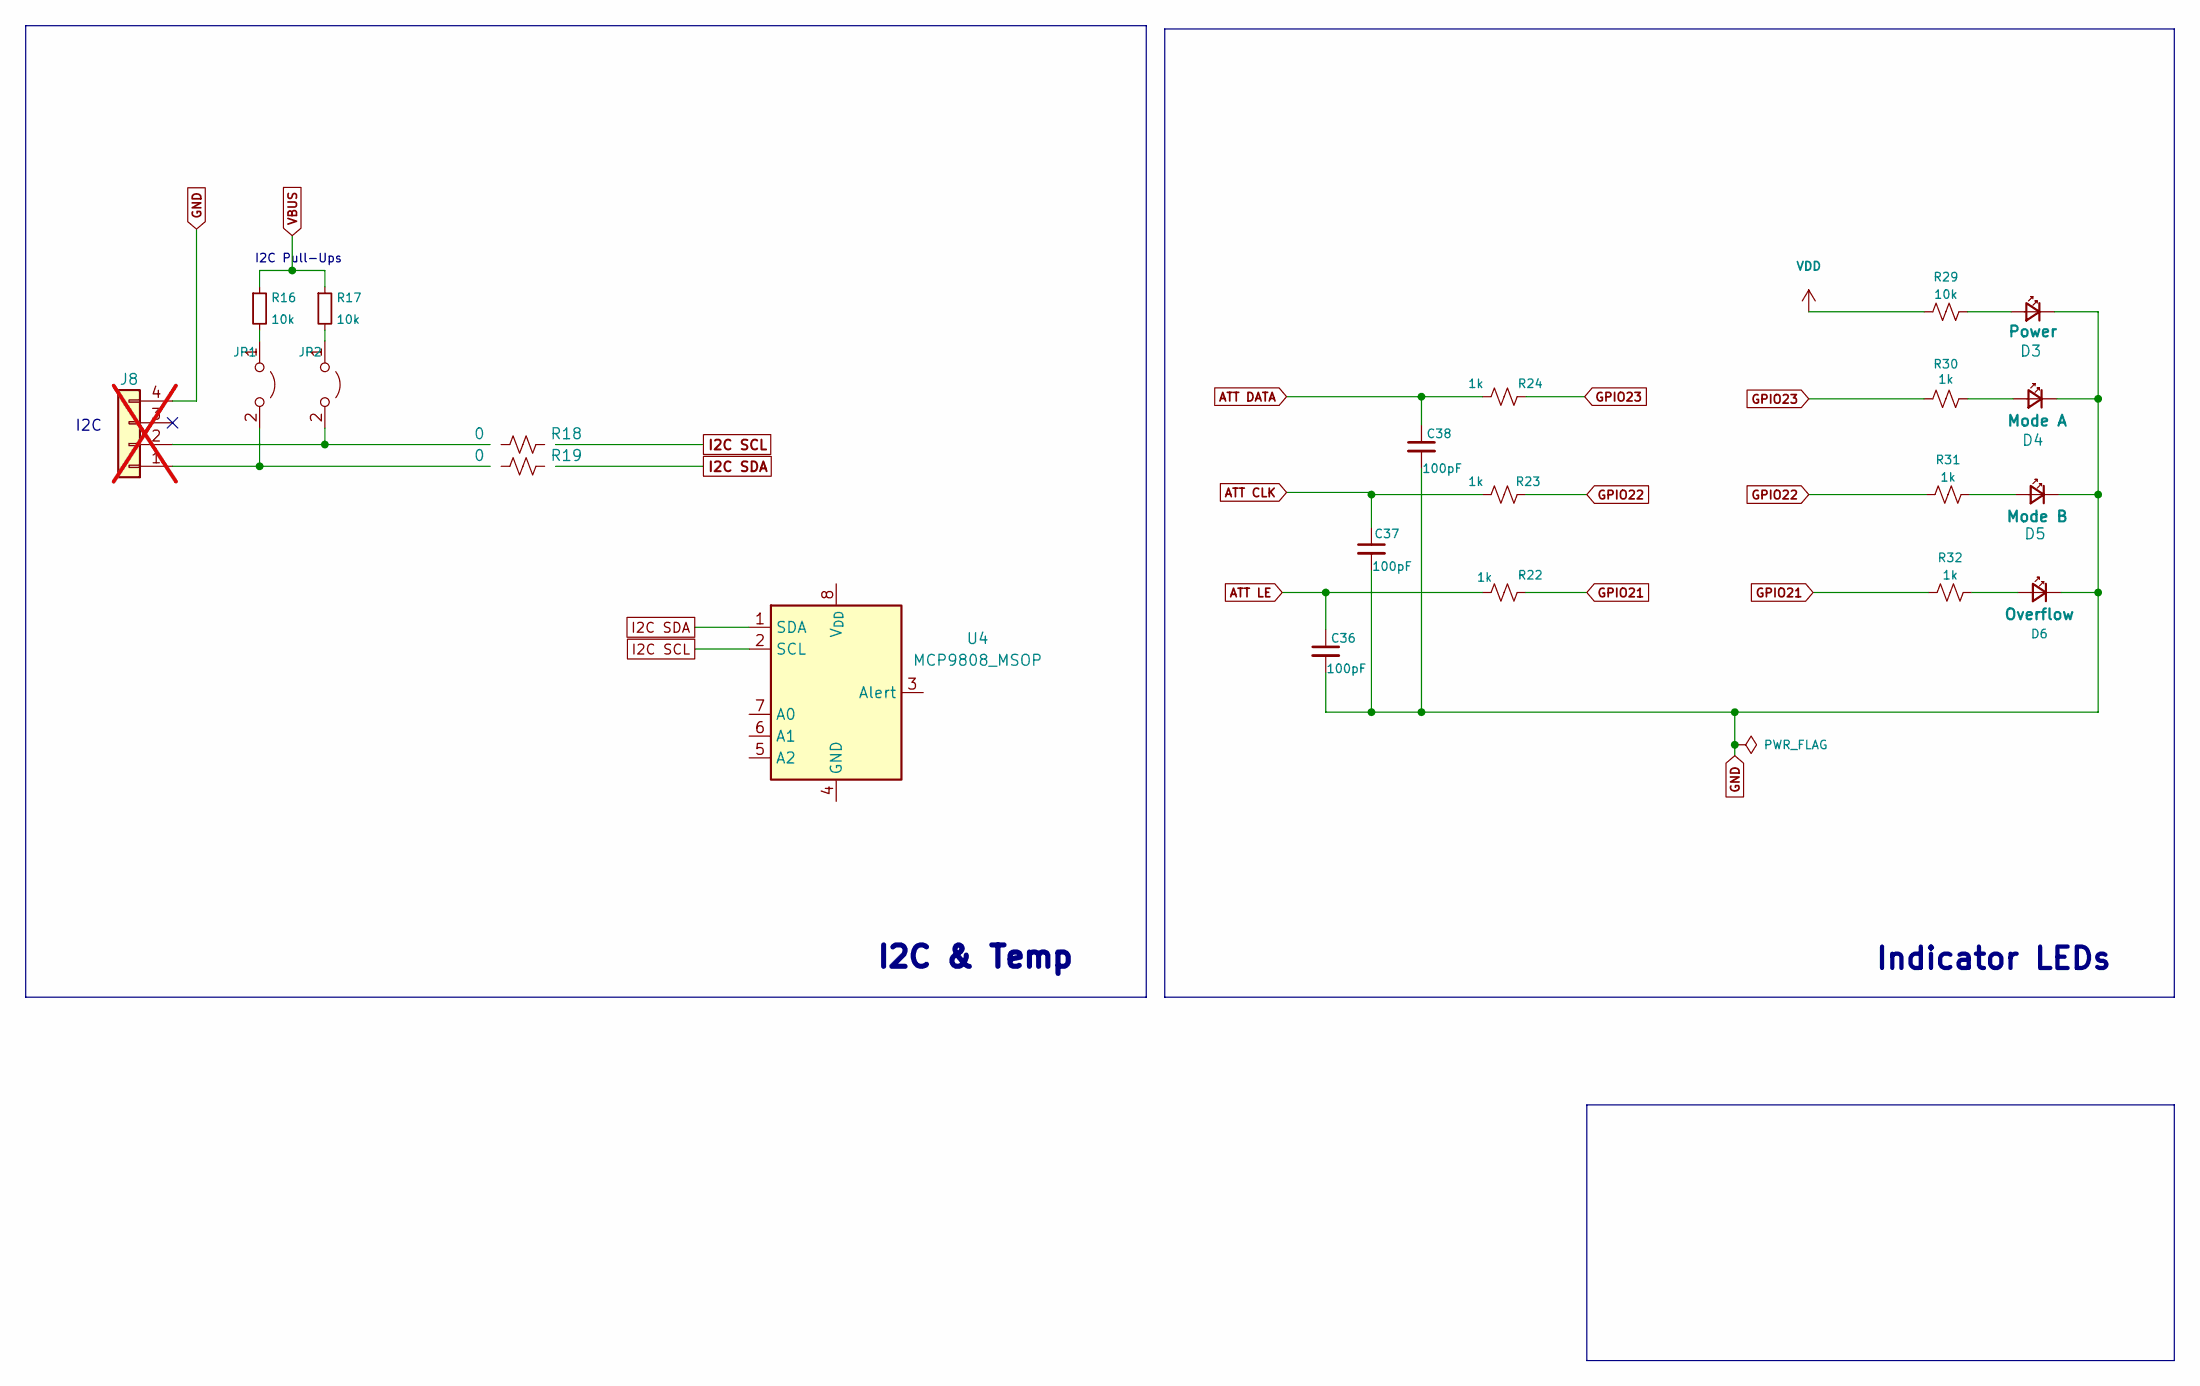
[picture p20: schematic PSWS-FX3-HF103-GPIO.kicad_sch]

Parts:
C36, C37, C38: 100pF; C_0603_1608Metric; LCSC C14858
D3: Power
D4: Mode A
D5: Mode B
D6: Overflow
J8: Conn_01x04; PinHeader_1x04_P1.27mm_Vertical; not fitted
JP1, JP2: Jumper_2_Open; SolderJumper-2_P1.3mm_Open_RoundedPad1.0x1.5mm
R16, R17: 10k; R_0603_1608Metric; LCSC C25804
R18, R19: 0; R_0603_1608Metric; LCSC C21189
R22, R23, R24: 1k; R_0603_1608Metric; LCSC C21190
R29: 10k
R30, R31, R32: 1k
U4: MCP9808_MSOP; MSOP-8_3x3mm_P0.65mm

Connections:
ATT CLK: C37.1, R23.2
ATT DATA: C38.1, R24.2
ATT LE: C36.1, R22.2
GND: C36.2, C37.2, C38.2, D3.1 (K), D4.1 (K), D5.1 (K), D6.1 (K), J8.4
GPIO21: R22.1, R32.2
GPIO22: R23.1, R31.2
GPIO23: R24.1, R30.2
I2C SCL: U4.2 (SCL)
I2C SDA: U4.1 (SDA)
unnamed: D3.2 (A), R29.1
unnamed: D4.2 (A), R30.1
unnamed: D5.2 (A), R31.1
unnamed: D6.2 (A), R32.1
unnamed: J8.1, JP1.2 (B)
unnamed: J8.2, JP2.2 (B)
unnamed: JP1.1 (A), R16.2
unnamed: JP2.1 (A), R17.2
VBUS: R16.1, R17.1
VDD: R29.2

Notes on the sheet:
Indicator LEDs
I2C
I2C & Temp
I2C Pull-Ups
