wittend/PSWS-FX3-HF103/PSWS-FX3-HF103-Power.kicad_sch

## KiCad design PSWS-FX3-HF103-Power.kicad_sch (2025-09-26)

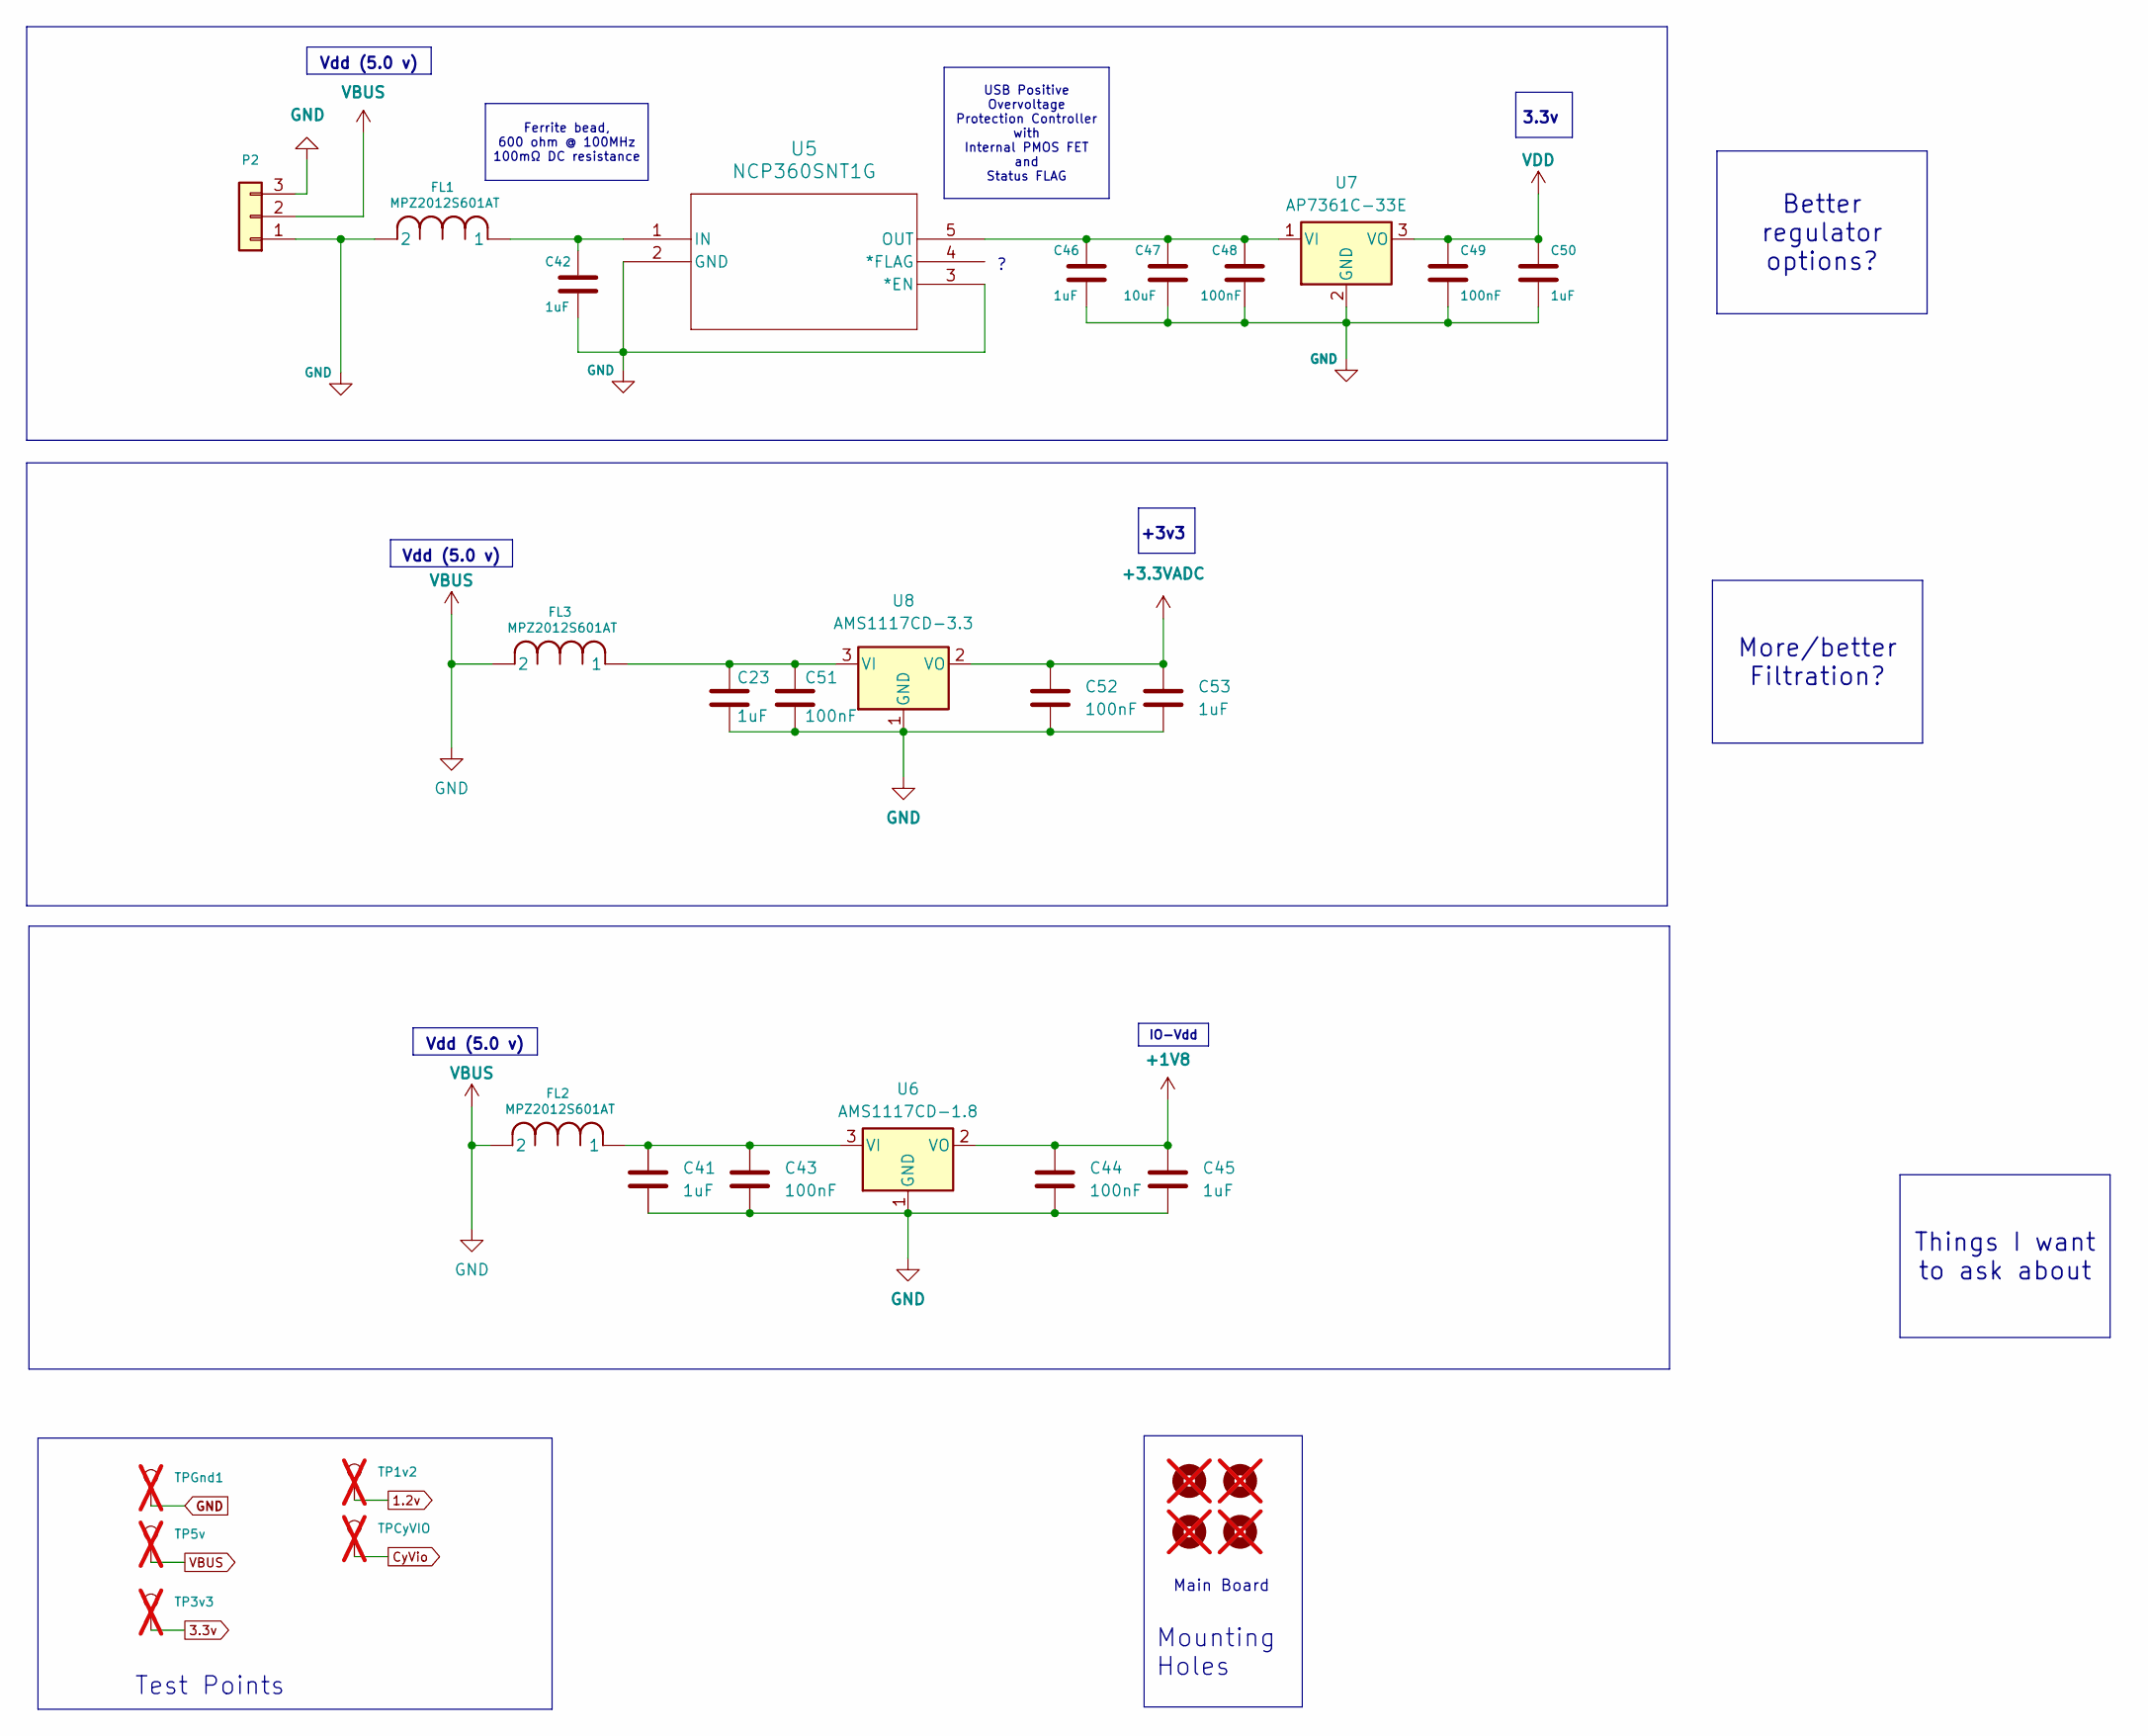
[picture p21: schematic PSWS-FX3-HF103-Power.kicad_sch]

Parts:
C23, C41, C42, C45, C46, C50, C53: 1uF; C_0805_2012Metric
C43, C44, C48, C49, C51, C52: 100nF; C_0805_2012Metric_Pad1.18x1.45mm_HandSolder
C47: 10uF; C_0805_2012Metric_Pad1.18x1.45mm_HandSolder
FL1, FL2, FL3: MPZ2012S601AT; IND_2012_TDK
H1, H2, H3, H4: MountingHole; MountingHole_3.2mm_M3_Pad_Via; not fitted
P2: Conn_01x03; PinHeader_1x03_P1.27mm_Vertical
TP1v1: TP1v2; TestPoint_THTPad_1.0x1.0mm_Drill0.5mm; not fitted
TP5: TP3v3; TestPoint_THTPad_1.0x1.0mm_Drill0.5mm; not fitted
TP5v1: TP5v; TestPoint_THTPad_1.0x1.0mm_Drill0.5mm; not fitted
TP6: TPCyVIO; TestPoint_THTPad_1.0x1.0mm_Drill0.5mm; not fitted
TPGnd1: TPGnd; TestPoint_THTPad_1.0x1.0mm_Drill0.5mm; not fitted
U5: NCP360SNT1G; TSOP5_3X1P5_ONS
U6: AMS1117CD-1.8; TO-252-3_TabPin2
U7: AP7361C-33E; SOT-223-3_TabPin2
U8: AMS1117CD-3.3; TO-252-3_TabPin2

Connections:
1.2v: TP1v1.1
3.3v: TP5.1
+1V8: C44.1, C45.1, U6.2 (VO)
+3.3VADC: C52.1, C53.1, U8.2 (VO)
CyVio: TP6.1
GND: C23.2, C41.2, C42.2, C43.2, C44.2, C45.2, C46.2, C47.2, C48.2, C49.2, C50.2, C51.2, C52.2, C53.2, FL1.2, FL2.2, FL3.2, P2.1, P2.2, P2.3, TPGnd1.1, U5.2 (GND), U5.3 (*EN), U6.1 (GND), U7.2 (GND), U8.1 (GND)
unnamed: C23.1, C51.1, FL3.1, U8.3 (VI)
unnamed: C41.1, C43.1, FL2.1, U6.3 (VI)
unnamed: C42.1, FL1.1, U5.1 (IN)
unnamed: C46.1, C47.1, C48.1, U5.5 (OUT), U7.1 (VI)
VBUS: TP5v1.1
VDD: C49.1, C50.1, U7.3 (VO)

Notes on the sheet:
More/better Filtration?
Vdd (5.0 v)
IO-Vdd
USB Positive Overvoltage Protection Controller with Internal PMOS FET and Status FLAG
Things I want to ask about
Ferrite bead, 600 ohm @ 100MHz 100mΩ DC resistance
Better regulator options?
Test Points
Main Board
3.3v
+3v3
Mounting Holes
