wittend/PSWS-FX3-HF103/PSWS-FX3-HF103-Timing.kicad_sch

## KiCad design PSWS-FX3-HF103-Timing.kicad_sch (2025-09-26)

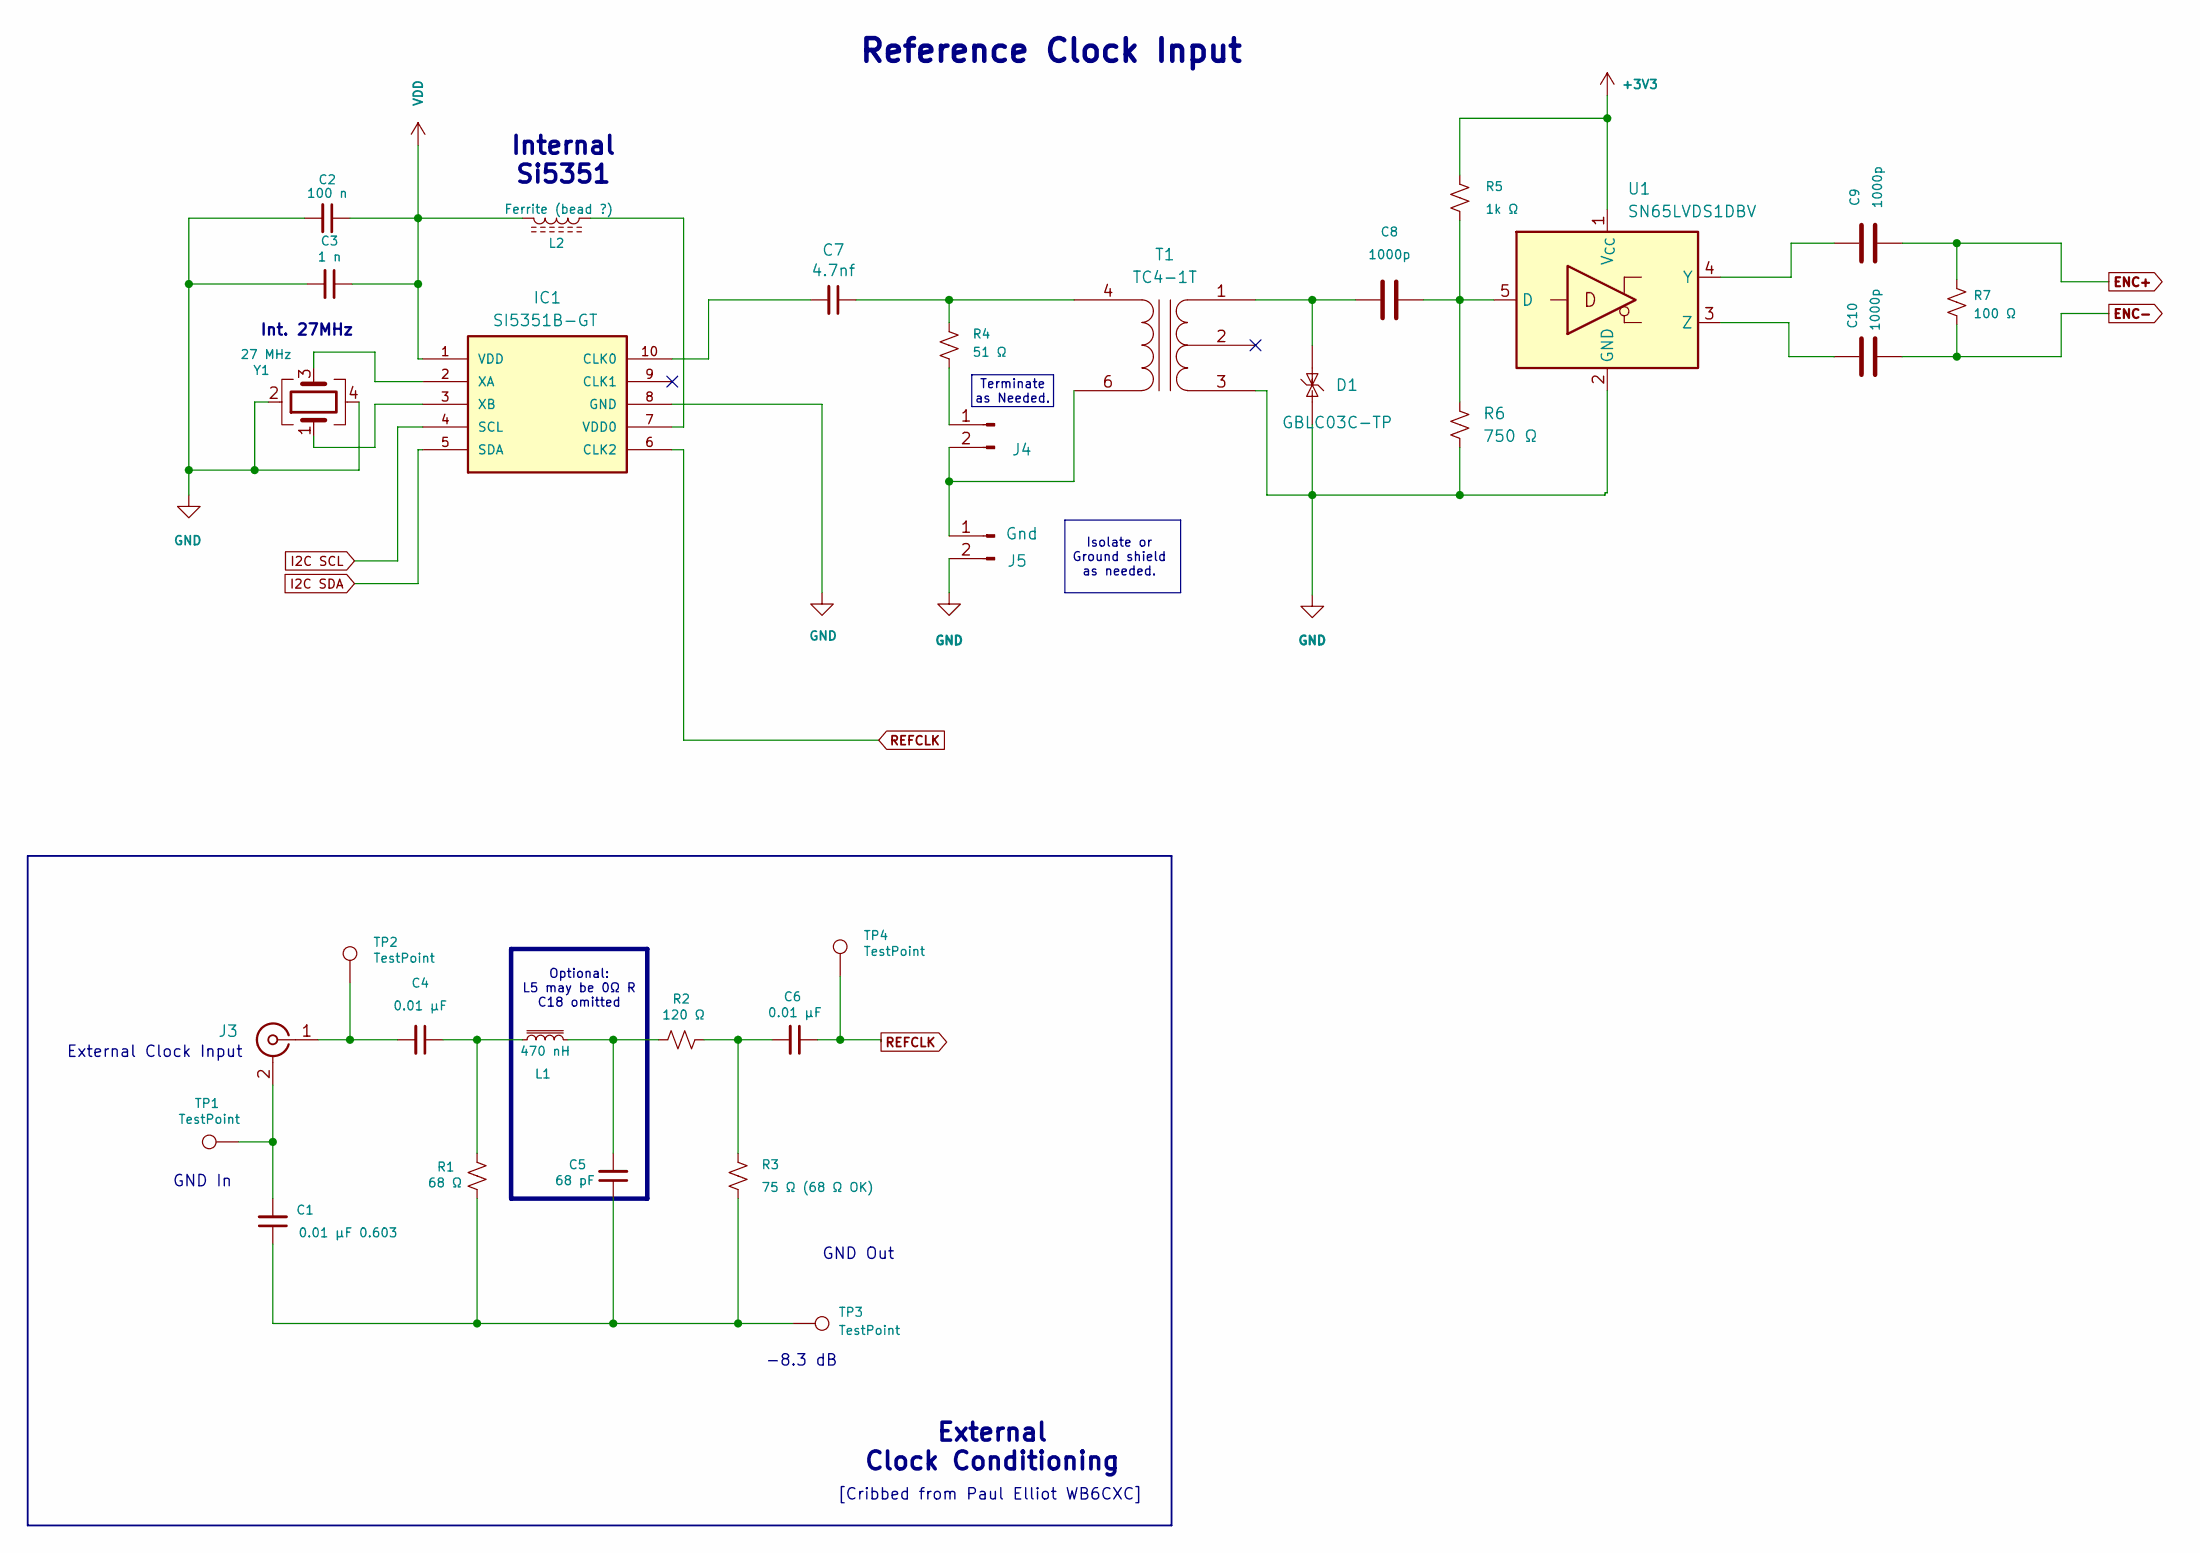
[picture p22: schematic PSWS-FX3-HF103-Timing.kicad_sch]

Parts:
C1: 0.01 μF 0.603; C_0201_0603Metric
C2: 100 n; C_0805_2012Metric
C3: 1 n; C_0805_2012Metric
C4, C6: 0.01 μF; C_0805_2012Metric
C5: 68 pF; C_0805_2012Metric
C7: 4.7nf; C_0402_1005Metric
C8, C9, C10: 1000p; C_0805_2012Metric
D1: (no value)
IC1: SI5351B-GT; SOP50P490X110-10N; MOUSER_PART_NUMBER 634-SI5351A-B-GT
J3: (no value)
J4, J5: Gnd
L1: 470 nH
L2: Ferrite (bead ?)
R1: 68 Ω; R_0603_1608Metric
R2: 120 Ω; R_0603_1608Metric
R3: 75 Ω (68 Ω OK); R_0603_1608Metric
R4: 51 Ω; R_0603_1608Metric
R5: 1k Ω; R_0603_1608Metric
R6: 750 Ω; R_0603_1608Metric
R7: 100 Ω; R_0603_1608Metric
T1: TC4-1T
TP1, TP2, TP3, TP4: TestPoint; TestPoint_Plated_Hole_D2.0mm
U1: SN65LVDS1DBV; SOT-23-5
Y1: 27 MHz; Oscillator_DIP-8

Connections:
+3V3: R5.1, U1.1 (V_{CC})
ENC+: C9.2, R7.1
ENC-: C10.2, R7.2
GND: C2.2, C3.2, D1.2 (A), IC1.8 (GND), J5.2, R6.2, T1.3 (SA), U1.2 (GND), Y1.2, Y1.4
I2C SCL: IC1.4 (SCL)
I2C SDA: IC1.5 (SDA)
unnamed: C1.1, C5.1, R1.2, R3.2, TP3.1
unnamed: C1.2, J3.2 (Ext), TP1.1
unnamed: C4.1, L1.1, R1.1
unnamed: C4.2, J3.1 (In), TP2.1
unnamed: C5.2, L1.2, R2.1
unnamed: C6.2, R2.2, R3.1
unnamed: C7.1, R4.1, T1.4 (AA)
unnamed: C7.2, IC1.10 (CLK0)
unnamed: C8.1, D1.1 (K), T1.1 (SB)
unnamed: C8.2, R5.2, R6.1, U1.5 (D)
unnamed: C9.1, U1.4 (Y)
unnamed: C10.1, U1.3 (Z)
unnamed: IC1.2 (XA), Y1.3
unnamed: IC1.3 (XB), Y1.1
unnamed: IC1.7 (VDD0), L2.1
unnamed: J4.1, R4.2
unnamed: J4.2, J5.1, T1.6 (AB)
REFCLK: C6.1, IC1.6 (CLK2), TP4.1
VDD: C2.1, C3.1, IC1.1 (VDD), L2.2

Notes on the sheet:
GND In
Terminate as Needed.
GND Out
Int. 27MHz
Optional: L5 may be 0Ω R C18 omitted
External Clock Conditioning
External Clock Input
Isolate or Ground shield as needed.
-8.3 dB
[Cribbed from Paul Elliot WB6CXC]
Internal Si5351
Reference Clock Input
